mfvazquez/PulseraTermicaAVR/Informe/Informe.pdf

Laboratorio de Microcomputadoras - 66.09

# Dispositivo Autorregulador de la Percepción Térmica Corporal

Profesor: | Ing. Guillermo Campiglio
Cuatrimestre/Año: | 1º/2015
Turno de las clases prácticas | miercoles
Jefe de trabajos prácticos: | Ricardo Arias
Docente guía: | Ricardo Arias
Autores | Seguimiento del proyecto
Gaston | Martinez | 91383
Matías | Vázquez | 91523

Observaciones:
Fecha de aprobación | Firma J.T.P

Coloquio
Nota final
Firma profesor

66.09 - Laboratorio de Microcomputadoras
er Cuatrimestre de 2015

## Índice

1. Objetivos | 2
2. Diseño | 5
3. Especificaciones del microcontrolador | 9
4. Software | 10
5. Resultados | 11
6. Conclusiones | 12
A. Codigo Proyecto | 13
B. Presupuesto | 25
C. Consumo de Corriente | 25
D. Referencias | 25
E. Datasheets | 25

## 1. Objetivos

Se diseñó e implementó una pulsera térmica que regula la temperatura de la muñeca del usuario. Se utiliza un módulo termoeléctrico para enviar variaciones de calor o frío a fin de modificar la percepción térmica del cuerpo.
Su función es generar pulsos de frío o calor, de manera de generar una sensación de confort para una persona en condiciones donde la temperatura es muy alta o muy baja respectivamente. Está basado en el proyecto Wristify [1] ganador del concurso de Intel: Make It Wearable [2].

### 1.1. Diagrama de Bloques

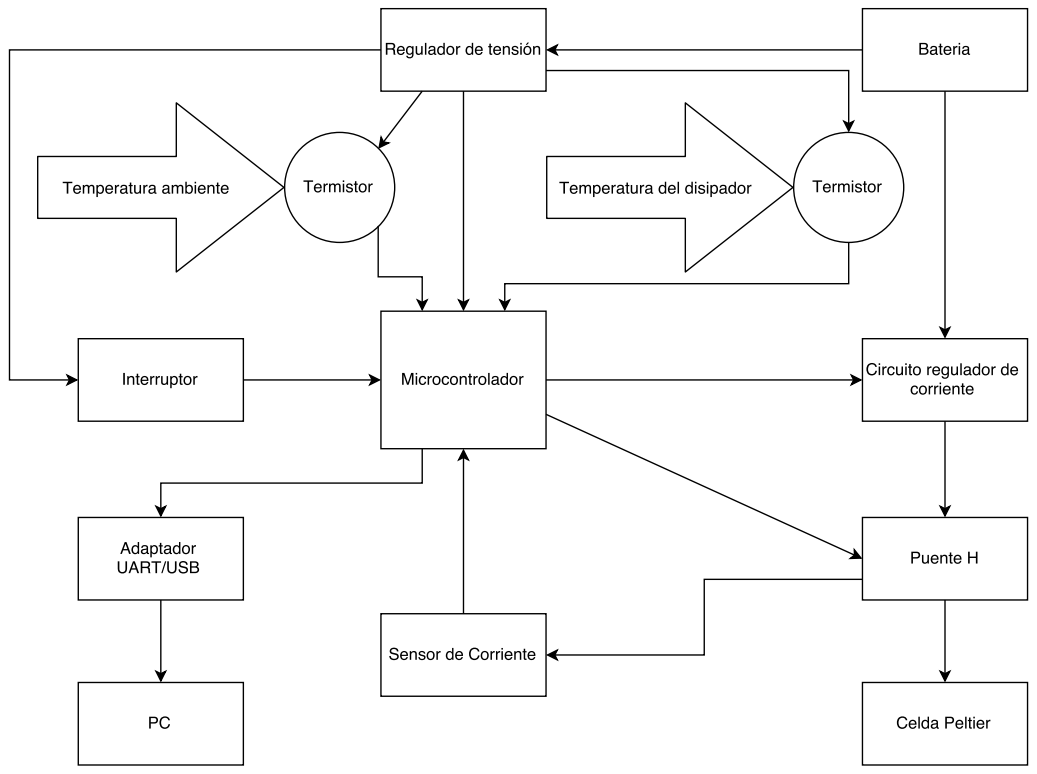
[picture p5: figure]

Figura 1: Diagrama de bloques

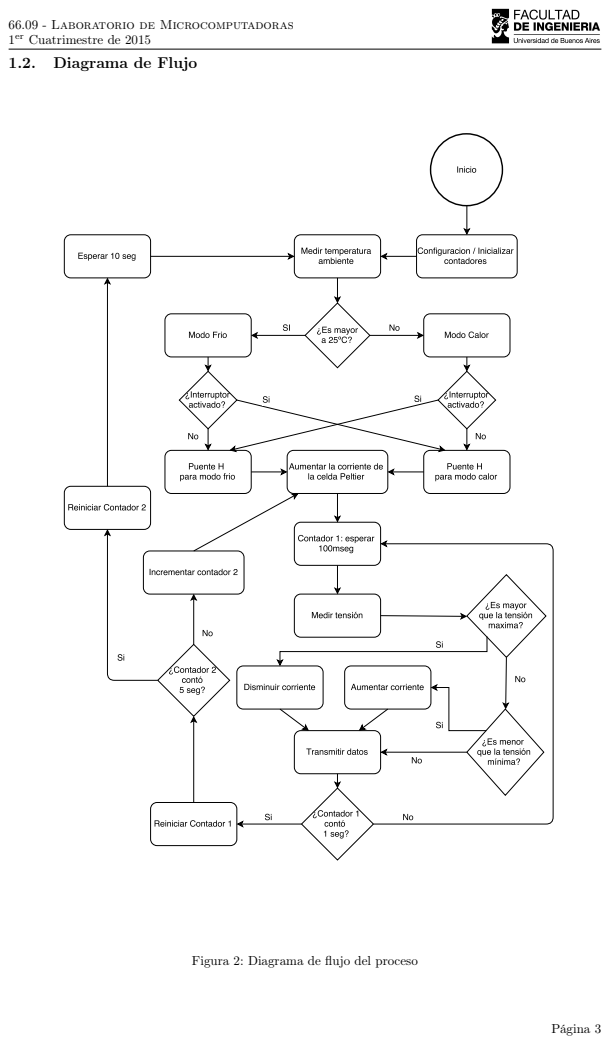
[picture p6: page 4]

1.2. Diagrama de Flujo

Figura 2: Diagrama de flujo del proceso

### 1.3. Especificaciones

El dispositivo utiliza una celda Peltier para enviar pulsos de calor o frío. De forma que se logra una diferencia de temperatura mayor a 0, 4

oC/seg. durante 5 segundos y durante los siguientes 10 segundos entra en estado de espera, para luego volver a iniciar el ciclo.
Cuenta con un termistor para medir la temperatura ambiente y analizar si debe enviar o recibir calor. Finalmente controla que se cumpla el ciclo en base a la corriente que circula por la celda Peltier.

### 1.3.1. Componentes

A continuación se lista la función de cada componente.

Celda Peltier: Realiza los cambios de temperatura en la muñeca del usuario.

Circuito regulador de corriente: Regula la corriente suministrada a la celda peltier.

Puente H: Invierte la polaridad de la celda Peltier, para así poder alternar entre modo frío o modo calor.

Disipador: La celda Peltier cuenta con un disipador para mantener la temperatura de una de sus caras a un valor cercano a la temperatura ambiente.

Termistores: Cuenta con dos termistores. Uno para medir la temperatura ambiente y en base a esta decidir el modo de trabajo, frío o calor. El segundo termistor mide la temperatura del disipador conectado a la celda Peltier para poder realizar una estimación de la temperatura de la celda.

Salida de puerto serie: Sirve para poder monitorear en una computadora la temperatura de la placa.

Adaptador UART-USB: Sirve para recibir los datos enviados desde el microcontrolador en una PC a través del puerto USB.

Bateria: Suministra la corriente necesaria a la celda Peltier y proporciona alimentación a todos los dispositivos utilizados.

Interruptor: Para poder invertir el estado de trabajo, de frío a calor y viceversa.

Controlador: Se utilizara un microcontrolador AVR. Es el encargado de obtener las temperaturas de los termistores para definir el modo de trabajo y autorregular la corriente de la celda Peltier mediante el circuito regulador de corriente.

## 2. Diseño

2.1. | Esquematico | V- 4 | V+

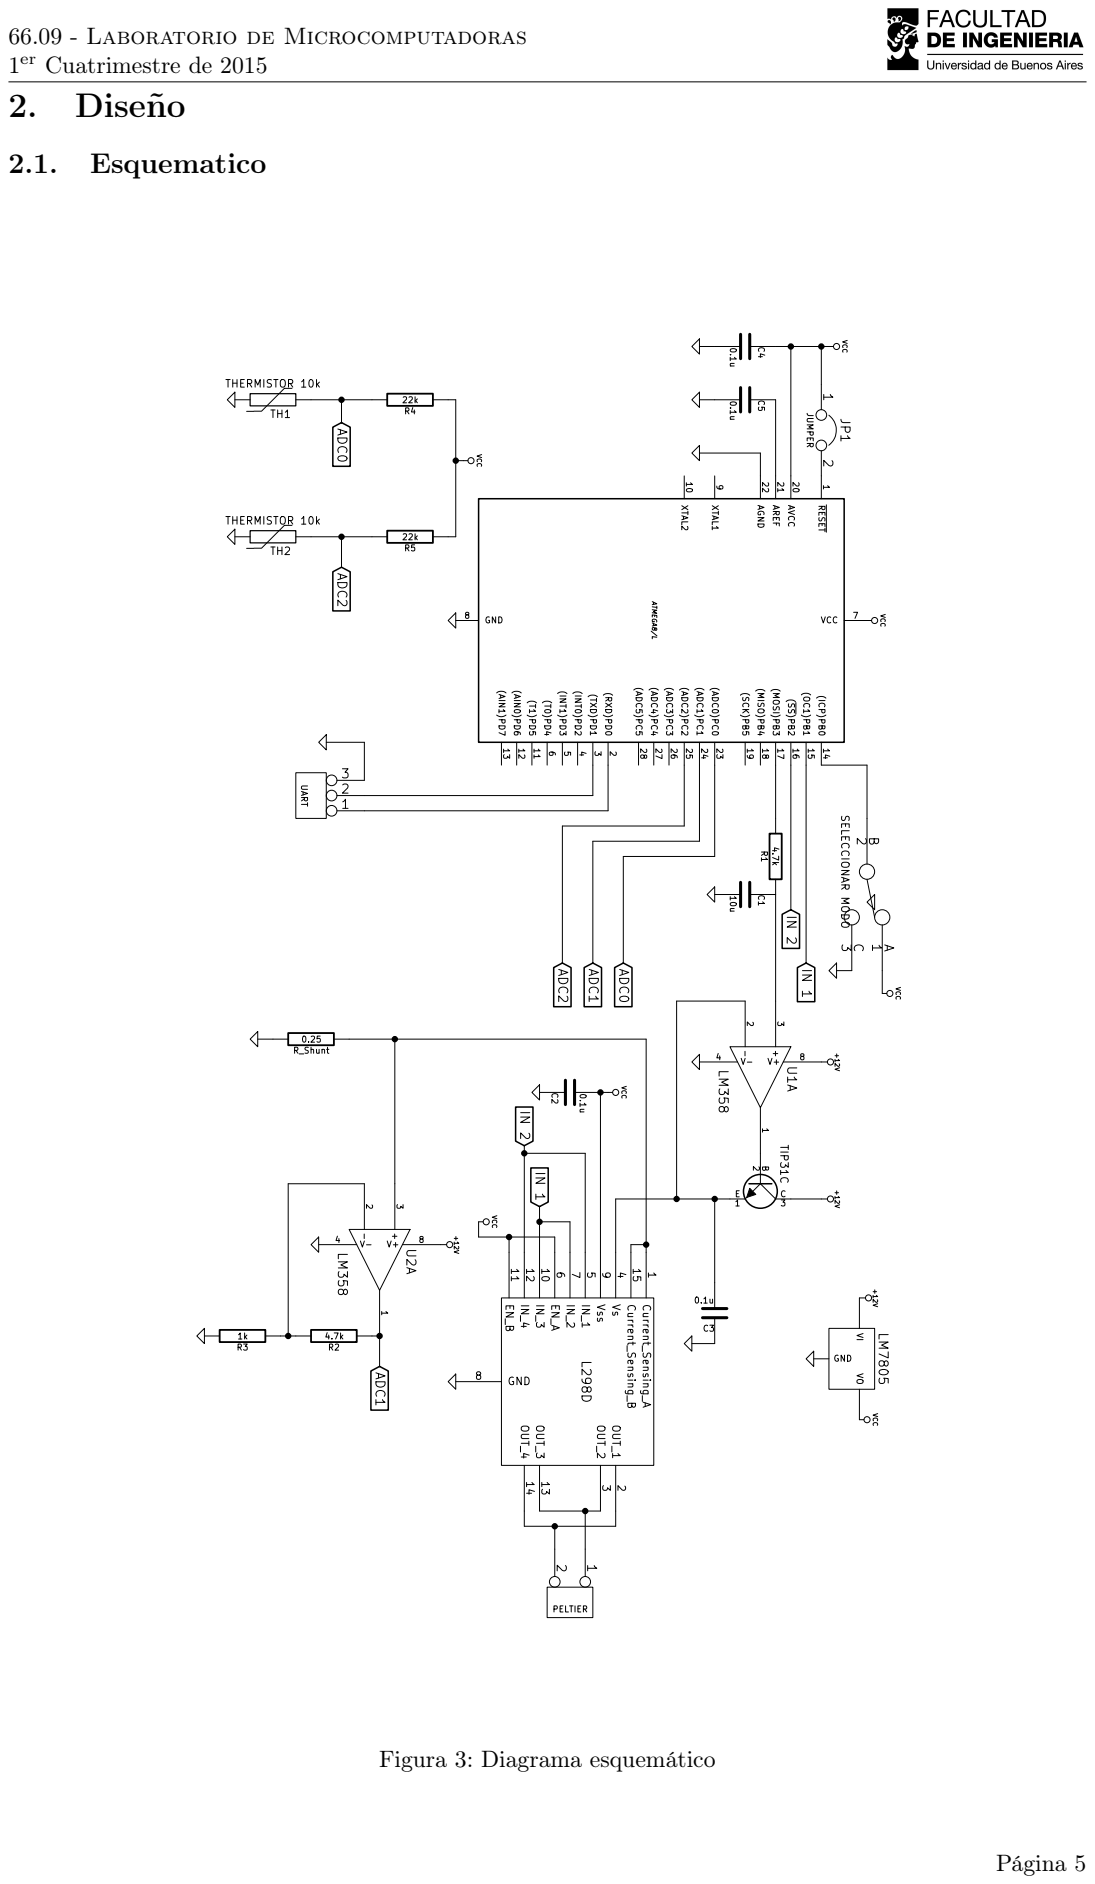
[picture p7: page 6]

### 2.2. Componentes

Celda Peltier: Celda peltier de 10W y 15 mmx15 mm

LM7805: Regulador de tensión para habilitar el puente H, alimentar el microcontrolador y suminis-trarle tensión constante a las resistencias conectadas en serie a los termistores.

Interruptor: Interruptor para activar la inversión de la polaridad.

Resistencias:

- Dos resiststencias de 4,7 kΩ
- Dos resiststencias de 22,0 kΩ
- Una resistencia de 1,0 kΩ

Capacitores:

- 1 capacitor de 10 µF para generar tensión constante del PWM recibido.
- 4 capacitores de 0.1 µF Conectados en paralelo a las alimentaciones del puente H, recomen-dados por el fabricante.

LM358: Dos amplificadores operacionales. Uno para suministrar corriente a la base del NPN y el segundo para amplificar la tensión leída sobre el shunt.

TIP31C: Transistor de potencia NPN, utilizado para regular la corriente.

L298D: Puente H utilizado para invertir la polaridad de la celda Peltier

Constantán: alambre de 2 cm (0,5 mm de diámetro) utilizado para sensar la corriente generada.

Bateria: de 12 V y 2,9 Ah

Pines:

- 3 pines para el puerto serie.
- 2 pines para el reseteo del microcontrolador.
- 2 pines para conectar la celda peltier al circuito.

Termistores: Dos termistores NTC de 10 kΩ

### 2.3. Regulador de Corriente con Puente H

Se utilizó un regulador de corriente controlado por un PWM como se muestra en la figura 4

er Cuatrimestre de 2015 | V⁻ 4 V⁺

8

1

- 2 | +
3 | U2A

LM358

E

1 B

2 TIP31C C
3 V- 4 V+

8

1

- 2 | +
3 | U1A

LM358

VI | VO GND LM7805
+12V | 1
2 | PELTIER

R1

4.7k | C1

10u

+12V | +12V
+12V | R² 4.7k 1k R³ C2
0.1u | C³ 0.1u
Current_Sensing_A 1 | OUT_1 | 2 OUT_2 | 3 Vs 4
IN_1 5 | EN_A 6
IN_2 7 | GND

8 Vss 9

IN_3 10 | EN_B 11
IN_4 12 | OUT_3 | 13 OUT_4 | 14 Current_Sensing_B 15 | L298D R_Shunt 0.25

VCC

VCC

VCC

IN 1 | ADC1

IN 2 OC2

Figura 4: Regulador de Corriente

El circuito RC filtra la señal del PWM generado por el microcontrolador. Presentando el valor medio en la entrada no inversora del LM358 U1A, cuya salida regula la corriente suministrada a la base del transistor NPN por el amplificador operacional, generando una corriente constante entre el colector y el emisor del transistor.
Se optó por utilizar un L298D para el puente H ya que cuenta en un mismo integrado con dos puentes H que soportan 2 A de corriente. Conectados en paralelo como se muestra en la figura 4 se puede duplicar dicha corriente máxima para que soporte hasta 4 A de corriente.
La corriente que circula por la celda se mide con una resistencia hecha con alambre constatán. La tensión que cae sobre este es amplificada por el LM358 U2A. Para que la tensión de salida varíe entre 0 V y 2,56 V y sea leído por el microcontrolador.
Las resistencias del amplificador U2A se obtuvieron considerando que para la corriente máxima registrada de 1,75 A, la salida no supere los 2,56 V. Siendo de 0,25 Ω la resistencia del alambre constantan .
La tensión de salida se obtiene mediante:

VADC1 = RconstantanIMAX

R3 + R2
R3

(1)

Luego fijando R3 = 1 kΩ y R2 = 4,7 kΩ se verificó que la tensión no supere los 2,56 V:

VADC1 = 0,25 Ω 1,75 A1 kΩ + 4,7 kΩ 1 kΩ = 2,49V < 2,56V

### 2.4. Medición de las temperaturas

Se utilizaron dos termistores. Uno para medir la temperatura ambiente y otro para la temperatura del disipador conectado a la celda Peltier para poder estimar la temperatura a la que se encuentra la celda. Ambos termistores están conectados de la misma manera como se indica a continuación.
Se utilizó un divisor resistivo para medir la tensión en los termistores y poder obtener la temperatura utilizando tablas con la relación entre la tensión leída y la temperatura a la que se encuentra. Se obtuvieron las resistencias a conectar en serie con los termistores de forma que la tensión máxima no supere los 2,56 V VI VO GND LM7805

+12V

# - TH2 THERMISTOR 10k 22k R5

ADC

Figura 5: Divisor de tensión de los termistores

Vtermistor = 5 V | Rtermistor
| Rtermistor + Rserie

(2)

Finalmente se eligió una resistencia de Rserie = 22 kΩ para R4 y R5 verificando que la tensión en los termistores no supere la tensión de referencia del ADC del microcontrolador para la resistencia máxima registrada en los termistores a R0

oC = 15 kΩ :

Vtermistor = 5 V | 15 kΩ
15 kΩ + 22 kΩ = 2 V

### 2.5. Interruptor selector de modo

La salida del interruptor es recibida por el microcontrolador, para en el siguiente ciclo invertir la polaridad de la celda Peltier mediante el puente H y evitar un cambio brusco de corriente en la celda Peltier.
El interruptor invierte el modo de trabajo actual. En caso de encontrarse el dispositivo a temperaturas ambiente menores a 25 oC automáticamente entra en modo calor. En caso de estar el interruptor habilitado entra en modo frío. Caso contrario ocurre para temperaturas ambiente mayores a 25 oC por defecto entra en modo frío, con el interruptor habilitado entra en modo calor.

## 3. Especificaciones del microcontrolador

### 3.1. Microcontrolador

Para este proyecto se utilizo un microcontrolador Atmega8L. El datasheet del mismo se puede obtener en la pagina de Atmel[4]

### 3.2. Configuraciones

### 3.2.1. Low Fuse

Se configuro este registro para que el clock del microcontrolador sea de 8MHz.
7 | 6 | 5 | 4 | 3 | 2 | 1 | 0
1 | 1 | 1 | 0 | 0 | 1 | 0 | 0
BODLVL | BODEN | SUT1 | SUT0 | CKSEL3 | CKSEL2 | CKSEL1 | CKSEL0

Solo se modificaron los valores de CKSEL, el resto de los bits fue dejado en la configuración que venia de fabrica.

### 3.2.2. UCSRC

Se configuro este registro para setear que el puerto serie envíe datos de 8bits, con un bit de stop y sin bit de paridad
7 | 6 | 5 | 4 | 3 | 2 | 1 | 0
1 | 0 | 0 | 0 | 0 | 1 | 1 | 0
URSEL | UMSEL | UPM1 | UPM0 | USBS | UCSZ1 | UCSZ0 | UCPOL

Configuracion segun el bit

Bit 7: Selecciona entre acceder el UCSRC seteando el bit en 1 o acceder al UBRRH seteando el bit en 0.

Bit 6: Modo Asincrónico

Bit 5 y 4: Sin bit de paridad

Bit 3: Un bit de STOP

Bit 2 y 1: Datos de 8 bits

Bit 0: 0 Por modo Asincrónico

### 3.2.3. UBRRL

Se configuro este registro para setear el Baud Rate del puerto serie a 38,4Mhz
7 | 6 | 5 | 4 | 3 | 2 | 1 | 0
0 | 0 | 0 | 0 | 1 | 1 | 0 | 0
UBRR[7:0]

### 3.2.4. TCCR2

Se configuro este registro para setear el modo de funcionamiento del contador 2.
7 | 6 | 5 | 4 | 3 | 2 | 1 | 0
0 | 1 | 1 | 1 | 0 | 0 | 0 | 1
FOC2 | WGM20 | COM21 | COM20 | WGM21 | CS22 | CS21 | CS20

Configuracion segun el bit

Bit 7: 0, por ser modo PWM

Bit 6 y 3: Modo PWM, Phase Correct

Bit 5 y 4: Modo set on match en subida y clear on match en bajada

Bit 2 - 0: Sin prescaler

### 3.2.5. ADCSRA

Se configuro este registro para el conversor analógico digital

7 | 6 | 5 | 4 | 3 | 2 | 1 | 0
1 | 1 | 0 | 0 | 1 | 1 | 1 | 1
ADEN | ADSC | ADFR | ADIF | ADIE | ADPS2 | ADPS1 | ADPS0

Configuracion segun el bit

Bit 7: Habilita ADC

Bit 6: Inicializa la conversión

Bit 5: Desabilita el free runing

Bit 4: Resetea el flag de interrupción pasandole 1

Bit 3: Habilita la interrupción

Bit 2 a 0: Factor de división: 128 para 111

## 4. Software

### 4.1. Monitoreo de datos

Durante la implementación del proyecto se monitorearon los datos manejados por el microcontrolador, para verificar su correcto funcionamiento, mediante un adaptador UART-USB. Para obtener los datos en una PC.
Finalizado el proyecto se utilizó este dispositivo para poder monitorear el correcto funcionamiento del mismo, enviando tanto la temperatura ambiente como la estimada de la celda Peltier y así poder verificar si cumple con los objetivos del proyecto.

### 4.2. Protocolo puerto serie

Para la comunicación desde el puerto serie se utilizo un protocolo con el siguiente formato:

Primer bloque: Un byte con un carácter ASCII alfanumerico identificador el dato a mandar.

Siguientes bloque: Uno o mas bytes con el dato a enviar. El receptor se debe encargar de deter-minar el largo de este en base a lo recibido en el primer bloque.

En particular para este proyecto, se utilizaron datos de un byte¹ y se enviaron con la configuración detallada en la sección 3.2.2 (Pagina: 9), con lo cual los paquetes enviados por puerto respetan el siguiente formato:

1-bit | 8-bits | 1-bit | 1-bit | 8-bits | 1-bit
START | Tipo de dato | STOP | START | Dato enviado | STOP

### 4.3. Autorregulación de la corriente

Para autorregular la corriente se armaron dos tablas, una para modo frío y otra para modo calor. En donde se muestra la relación entre la tensión amplificada del RShunt y la temperatura a la que se encuentra la celda Peltier. La tabla a utilizar depende del modo de operación, frío o calor.
Durante la ejecución del programa se recorre dicha tabla utilizando un iterador que avanza de posición en cada segundo. En base a la posición del iterador se obtienen las tensiones máximas y mínimas, para regular el PWM de forma que la tensión leída se encuentre entre dichos valores.
Las tablas se armaron de forma que en la ultima iteración no llegue a temperaturas que puedan dañar al usuario. Para el modo calor se procuró no superar los 40 oC en el fin del ciclo, y para el modo frio se procuró que la temperatura no sea menor a los 12 oC.

1Esto fue en parte una consecuencia de la elección del modelo del microcontrolador. Por otro lado, tampoco eran necesarios datos mas grandes.

## 5. Resultados

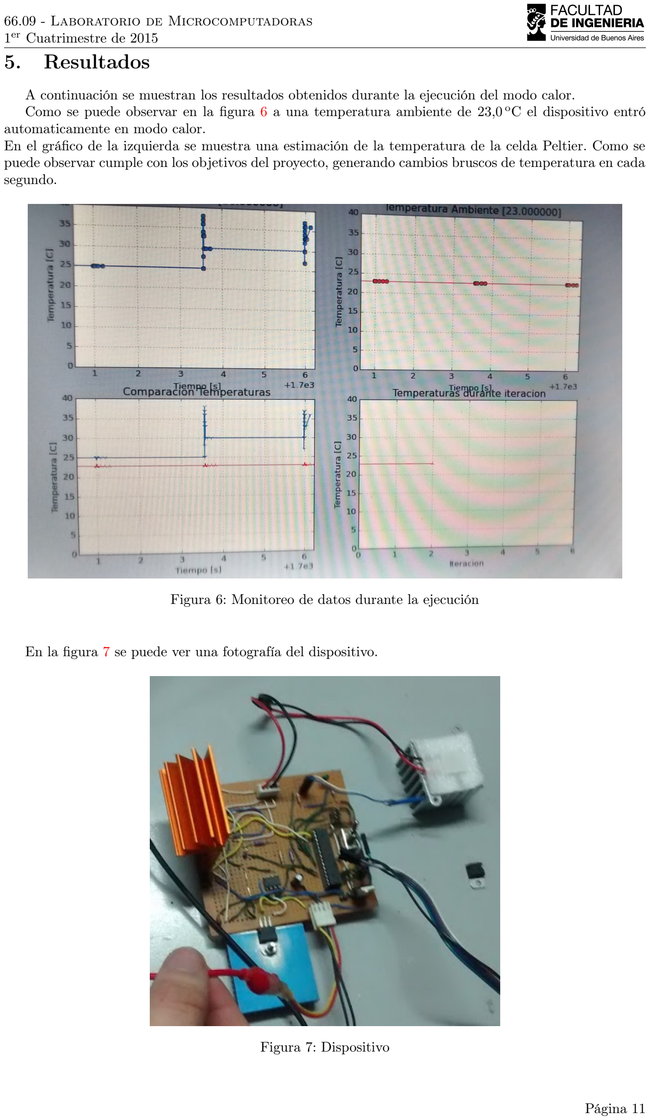
[picture p8: page 12]

A continuación se muestran los resultados obtenidos durante la ejecución del modo calor. Como se puede observar en la figura 6 a una temperatura ambiente de 23,0

oC el dispositivo entró
automaticamente en modo calor.
En el gráfico de la izquierda se muestra una estimación de la temperatura de la celda Peltier. Como se puede observar cumple con los objetivos del proyecto, generando cambios bruscos de temperatura en cada segundo.

Figura 6: Monitoreo de datos durante la ejecución

En la figura 7 se puede ver una fotografía del dispositivo.

Figura 7: Dispositivo

## 6. Conclusiones

La función del dispositivo es lograr una sensación de confort térmico mediante el envío de pulsos de calor o frío a la muñeca del usuario. Ya que el cuerpo humano al ser sometido a cambios de temperatura en alguna parte del cuerpo obtiene una sensación de frío o calor en todo el cuerpo, según el cambio sufrido.
Si bien se logró cumplir con los objetivos del proyecto, no se notaron cambios en la percepción térmica corporal, sí en la muñeca pero no en todo el cuerpo. Como se trata de algo tan relativo entre cada individuo, se deberían realizar mas pruebas con distintas diferencias de temperatura entre cada segundo, y evaluarlo a distintas temperaturas ambientes.
Las pruebas realizadas se centraron mas en el modo calor ya que actualmente nos encontramos en períodos de frío. Una tarea pendiente es probar el dispositivo durante días de calor para evaluar los efectos del modo frío.
Una posible mejora sería que el usuario pueda ajustar las diferencias de temperatura. Y que el dispositivo registre cuando el usuario utiliza el interruptor para cambiar de modo, y almacenar esa temperatura ambiente como la temperatura en la cual el dispositivo cambia de modo.
Las celdas Peltier son dispositivos muy delicados, por lo que requieren estar bien protegidas contra posibles impactos, ya que el mínimo impacto las daña permanentemente. No se logró encontrar una relación simple entre la corriente de la celda y su diferencia de temperatura, ya que esta no sólo depende de la corriente sino también de la temperatura inicial y del tiempo. Por los datos medidos para realizar las tablas se llegó a la conclusión de que la corriente fija una velocidad a la que la temperatura variará durante intervalos cortos.
Fue mas fácil regular el modo frío ya que al iniciar el standby la temperatura regresaba rápidamente a su valor inicial. En cambio para el modo calor, al iniciar el standby la celda peltier no llega a enfriarse hasta obtener su valor inicial luego del standby, por lo que en cada ciclo irá acumulando temperatura hasta llegar a un valor máximo que depende de la corriente máxima que reciba.
Una mejora a este problema sería que durante el modo calor, al iniciar el standby entre en modo frío y reduzca la temperatura del peltier hasta obtener la temperatura ambiente. El problema que conlleva esta solución es que el transistor que regula la corriente se calentará más al no tener un período de standby de 10 segundos sin transmitir corriente.
Por las mismas razones mencionadas sobre el comportamiento de la celda Peltier, deducir su temperatura en base a la temperatura del disipador y la corriente que circula por la celda devuelve datos poco precisos, lo que se podría calcular es la diferencia de temperatura entre cada pulso con el inicio del ciclo. Para medir la temperatura del Peltier se deberá poner un termistor o termocupla entre el peltier y el disipador para obtener en base a esta la temperatura del peltier.
Finalmente, para lograr las condiciones especificadas por el proyecto no es necesario generar corrientes altas. Con una corriente máxima de 500 mA bien reguladas se hubiese logrado el objetivo del producto y se habría reducido su tamaño debido a que no requiere una batería de gran tamaño.

## A. Codigo Proyecto

A.1. | Pulsera.S
1 | #include <avr / i o. h >
3 | .s e c t ion .data
.org 0 x000

5
Temp_Ambiente : | .byte 0
7 | Temp_Disipador : .byte 0
Temp_Peltier : | .byte 0
9 | Ten sion_Salida : .byte 0
11 | Modo_Operacion : .byte 0
13 | Modo_Standby : | .byte 0
15 | PWM: | .byte 0
Tension_min : | .byte 0
17 | Tension_max : | .byte 0
I t e r a d o r : | .byte 0

19
.s e c t ion .t ext
21 .org 0 x0
.g loba l main
23 | rjmp | main
25 | #define low( x ) | lo8 ( x )
#define high( x ) | hi8 ( x )

27
; Regs :
29 ; r16 : Temporal , p a s a j e de parame tro y de r e t o r n o #define Reg_Temporal r16

31
; r20 : Contador
33 | #define Contador r20
35 | ; C on s t an te s :
; T ipos de d a t o para mandar por s e r i a l

37
| #define Dato_Tempe_Ambiente | ’A’
39 | #define Dato_Tempe_Disipador | ’T ’
| #define Dato_Num_Iteracion | ’ I ’
41 | #define Dato_Tension_Salida | ’P ’
| #define Dato_Tempe_Peltier | ’X’
43 | #define Dato_PWM | ’W’
| #define Dato_max | ’M’
45 | #define Dato_min | ’N’
47 | #define Incremento_Pulso_Calor | 3
| #define Incremento_Pulso_Frio | 10
49 | #define Incremento_Regulacion | 1
| #define PWM_inicial | 95

51

53 | #define Eeprom_Inicio_Calor | 0 x64
| #define Eeprom_Inicio_Frio | 0 x94

55

57 ; S a l t e a e l v e c t o r de i n t e r r u p c i o n .org 0 x0020
59 | main:
61 | STACK_Init :
l d i | Reg_Temporal , | low(RAMEND)
63 | out | _SFR_IO_ADDR(SPL) , | Reg_Temporal
l d i | Reg_Temporal , | high(RAMEND)
65 | out | _SFR_IO_ADDR(SPH) , | Reg_Temporal
67 | r c a l l | PWM_Init
r c a l l | PUENTE_H_Init
69 | r c a l l | USART_Init
71 | LOOP:
c l r | Contador

73
r c a l l | GET_MODE | ; ob te ng o e l modo de o p e r ac i o n

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

79
REDUCIR_LOOP:

81
mov | Reg_Temporal , | Contador

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

87

89 | inc | Contador | ; Cumpli una v u e l t a
l d i | Reg_Temporal , | 6
91 | cpse | Contador , | Reg_Temporal | ;No s a l t a r s i ya e j e c u t o 5 v u e l t a s
93 | rjmp | REDUCIR_LOOP
95 | cb i | _SFR_IO_ADDR(DDRB) , 3 | ; (OC2) para s a l i d a
sb i | _SFR_IO_ADDR(DDRB) , 3 | ; (OC2) para s a l i d a
97 | cb i | _SFR_IO_ADDR(PORTB) , 3
99 | r c a l l STANDBY
rjmp LOOP

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

117 | inc | Reg_Temporal
| sts | I t e r a d o r , | Reg_Temporal
119 | r c a l l | LEER_EEPROM
| sts | Tension_min , | r25

121
| inc | Reg_Temporal
123 | inc | Reg_Temporal
| r c a l l | LEER_EEPROM
125 | sts | Tension_max , | r25
127 | lds | r29 , | PWM
out | _SFR_IO_ADDR(OCR2) , r29

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

171
| MODO_FRIO:
173 | sb i | _SFR_IO_ADDR(PORTB) , 1
cb i | _SFR_IO_ADDR(PORTB) , 2
175 | ret

177 | MODO_CALOR:
cb i | _SFR_IO_ADDR(PORTB) , 1
179 | sb i | _SFR_IO_ADDR(PORTB) , 2
| ret
181 | ;−−−−−−−−−−−−−−−−−−−−−−−−−−−−−−−−−−−−−−−−−−−−−−−−−−−−−−−−−−−−−−−−−−−−−−−−−−−−−−−−−−−−−
183 | TRANSMITIR_DATOS:
| r c a l l | LEER_AMBIENTE
185 | r c a l l | LEER_DISIPADOR
| r c a l l | LEER_PELTIER

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

193
| l d i | Reg_Temporal , | Dato_Tempe_Ambiente | ; t i p o de d a t o a mandar
195 | r c a l l | USART_Transmit
| lds | Reg_Temporal , | Temp_Ambiente
197 | r c a l l | USART_Transmit
199 | l d i | Reg_Temporal , | Dato_Tension_Salida | ; t i p o de d a t o a mandar
| r c a l l | USART_Transmit
201 | lds | Reg_Temporal , | Ten sion_Salida
| r c a l l | USART_Transmit

203
| l d i | Reg_Temporal , | Dato_Tempe_Disipador | ; t i p o de d a t o a mandar
205 | r c a l l | USART_Transmit
| lds | Reg_Temporal , | Temp_Disipador
207 | r c a l l | USART_Transmit
209 | l d i | Reg_Temporal , | Dato_Tempe_Peltier | ; t i p o de d a t o a mandar
| r c a l l | USART_Transmit
211 | lds | Reg_Temporal , | Temp_Peltier
| r c a l l | USART_Transmit

213
| l d i | Reg_Temporal , | Dato_PWM | ; t i p o de d a t o a mandar
215 | r c a l l | USART_Transmit
| lds | Reg_Temporal , | PWM
217 | r c a l l | USART_Transmit
219 | l d i | Reg_Temporal , | Dato_min | ; t i p o de d a t o a mandar
| r c a l l | USART_Transmit
221 | lds | Reg_Temporal , | Tension_min
| r c a l l | USART_Transmit

223
| l d i | Reg_Temporal , | Dato_max | ; t i p o de d a t o a mandar
225 | r c a l l | USART_Transmit
| lds | Reg_Temporal , | Tension_max
227 | r c a l l | USART_Transmit
229 | ret
231 | ;−−−−−−−−−−−−−−−−−−−−−−−−−−−−−−−−−−−−−−−−−−−−−−−−−−−−−−−−−−−−−−−−−−−−−−−−−−−−−−−−−−−−−
LEER_AMBIENTE:
233 | l d i | Reg_Temporal , | 0 b11000000 | ; c a n al 0 tem pe r a tu r a amb ien te
| r c a l l | READ_ADC | | ; l e e r t e n s i o n d e l p e l t i e r
235 | r c a l l | TRADUCIR_TERMISTOR
| sts | Temp_Ambiente , | Reg_Temporal

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

257
| SET_PWM:
259 | lds | r30 , PWM
| lds | Reg_Temporal , | Modo_Standby
261 | cp i | Reg_Temporal , | 1
; S i e s t a en modo s t a n d by no r e a l i z a camb ios
263 | breq | APLICAR_CAMBIO
265 | lds | r29 , | Ten sion_Salida
| lds | r17 , | Tension_min
267 | lds | r18 , | Tension_max
l d i | r26 , | Incremento_Regulacion ; v a l o r a s e r r e s t a d o o | sumado

269
| cp | r29 , | r17
271 | brlo | AUMENTAR
273 | cp | r29 , | r18
| brlo | APLICAR_CAMBIO

275
| DISMINUIR :
277 | cp i | r30 , | 100
| breq | APLICAR_CAMBIO
279 | add | r30 , | r26
| rjmp | APLICAR_CAMBIO
281 | AUMENTAR:
| cp i | r30 , | 0
283 | breq | APLICAR_CAMBIO
| sub | r30 , | r26
285 | APLICAR_CAMBIO:
| sts | PWM, | r30
287 | out | _SFR_IO_ADDR(OCR2) , r30
| ret
289 | ;−−−−−−−−−−−−−−−−−−−−−−−−−−−−−−−−−−−−−−−−−−−−−−−−−−−−−−−−−−−−−−−−−−−−−−−−−−−−−−−−−−−−−
; Aumenta e l p u l s o de c a l o r / f r i o d e l segundo que r e c i e n emp ieza ,
291 ; Carga l a t e n s i o n minima y maxima l e i d a s de eeprom de l a i t e r a c i o n
; c o r r e s p o n d i e n t e .
293 | AUMENTAR_PULSO:
| c l r | r17

295
| lds | Reg_Temporal , | I t e r a d o r

297 | inc | Reg_Temporal
| inc | Reg_Temporal
299 | sts | I t e r a d o r , | Reg_Temporal
301 | r c a l l | LEER_EEPROM
| sts | Tension_min , | r25
303 | inc | Reg_Temporal
| inc | Reg_Temporal
305 | r c a l l | LEER_EEPROM
| sts | Tension_max , | r25

307
| lds | r31 , | Modo_Operacion
309 | cp i | r31 , | 0
| breq | AUMENTO_FRIO
311 | AUMENTO_CALOR:
l d i | r26 , | Incremento_Pulso_Calor
313 | r c a l l AUMENTAR
| ret
315 | AUMENTO_FRIO:
l d i | r26 , | Incremento_Pulso_Frio
317 | r c a l l | AUMENTAR
| ret

319
;−−−−−−−−−−−−−−−−−−−−−−−−−−−−−−−−−−−−−−−−−−−−−−−−−−−−−−−−−−−−−−−−−−−−−−−−−−−−−−−−−−−−−
321 | ; Espera d u r an te 100mseg
| DEMORA:
323 | l d i | Reg_Temporal , | 0xCF | ; V al o re s de l o s que emp ieza | a c o n t a r
out | _SFR_IO_ADDR(TCNT1H) , Reg_Temporal
325 | l d i | Reg_Temporal , | 0x2B
out | _SFR_IO_ADDR(TCNT1L) , Reg_Temporal
327 | l d i | Reg_Temporal , | 4 | ; 0000 0100 h a b i l i t a poner en 1
out | _SFR_IO_ADDR(TIFR ) , Reg_Temporal | ; R e i n i c i a e l o v e r f l o w f l a g
329 | out | _SFR_IO_ADDR(TIMSK) , Reg_Temporal | ; b i t 2 en 1 h a b i l i t a l a i n t e r r u p c i o n por o v e r f l o w
| l d i | Reg_Temporal , | 0 b00000011 | ; v e l o c i d a d : c l k /64
331 | out | _SFR_IO_ADDR(TCCR1B) , Reg_Temporal
333 | DEMORA_LOOP:
in | Reg_Temporal , | _SFR_IO_ADDR(TIFR)
335 | sbrs | Reg_Temporal , | 2
| rjmp | DEMORA_LOOP

337
| l d i | Reg_Temporal , | 1
339 | out | _SFR_IO_ADDR(TIFR ) , Reg_Temporal | ; Se l im p i a TIRF
| c l r | Reg_Temporal | | ; f i n a l i z o c on t a d o r
341 | out | _SFR_IO_ADDR(TIFR ) , Reg_Temporal
out | _SFR_IO_ADDR(TCCR1B) , Reg_Temporal

343
ret

345

347 ;−−−−−−−−−−−−−−−−−−−−−−−−−−−−−−−−−−−−−−−−−−−−−−−−−−−−−−−−−−−−−−−−−−−−−−−−−−−−−−−−−−−−− ; S tandby
349 ; Espera d u r an te 10 segundos , s e t e a e l PWM en 255 para no ge ne r a r c o r r i e n t e .
STANDBY:
351 | l d i | Reg_Temporal , | 1
| sts | Modo_Standby , | Reg_Temporal
353 | l d i | r29 , | 255 | ;PWM
| sts | PWM, | r29
355 | r c a l l | SET_PWM
| l d i | r27 , | 100

357 | r c a l l | ESPERA
| c l r | Reg_Temporal
359 | sts | Modo_Standby , | Reg_Temporal
| ret

361
;−−−−−−−−−−−−−−−−−−−−−−−−−−−−−−−−−−−−−−−−−−−−−−−−−−−−−−−−−−−−−−−−−−−−−−−−−−−−−−−−−−−−− 363 ; Transm it
; Transm i te por e l p u e r t o p a r a l e l o e l d a t o pasado como parame tro
365 | ; Reg_Temporal : v a l o r a t r a n s m i t i r
367 | USART_Transmit :
sb is | _SFR_IO_ADDR(UCSRA) ,UDRE | ; Espero a que se l i b e r e e l UDRE
369 | rjmp | USART_Transmit
371 | out | _SFR_IO_ADDR(UDR) , | Reg_Temporal
| ret

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

377
| USART_Init :
379 | l d i | Reg_Temporal , | (1<<TXEN) | ; e n a bl e
out | _SFR_IO_ADDR(UCSRB) , Reg_Temporal

381
l d i | Reg_Temporal , | (1<<URSEL)|(3<<UCSZ0) | ; 8 b i t s , 1 b i t de s t o p | , s i n b i t de p a r i d a d
383 | out | _SFR_IO_ADDR(UCSRC) , Reg_Temporal
385 | l d i | Reg_Temporal , | 0xC | ; Baud 38400 ( Clock de 8Mhz)
out | _SFR_IO_ADDR(UBRRL) , Reg_Temporal

387
ret

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

395
| READ_ADC:

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

401
WAIT_ADC:
403 | ; Espera a que f i n a l i c e l a l e c t u r a
| in | Reg_Temporal , | _SFR_IO_ADDR(ADCSRA)
405 | sbrs | Reg_Temporal , | 4
| rjmp | WAIT_ADC

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

409
| in | Reg_Temporal , | _SFR_IO_ADDR(ADCL)
411 | in | r17 , | _SFR_IO_ADDR(ADCH)
| l s r | r17
413 | ror | Reg_Temporal
| l s r | r17
415 | ror | Reg_Temporal

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

427
;−−−−−−−−−−−−−−−−−−−−−−−−−−−−−−−−−−−−−−−−−−−−−−−−−−−−−−−−−−−−−−−−−−−−−−−−−−−−−−−−−−−−− 429 ; Traduc ir t e r m i s t o r
; C o n v i e r t e e l v a l o r r e c i b i d o por parame tro en su tem pe r a tu r a e q u i v a l e n t e
431 | ; en t r a d a : Reg_Temporal : v a l o r l e i d o por e l ADC
433 | TRADUCIR_TERMISTOR:
| mov | r18 , | Reg_Temporal
435 | l d i | r17 , | 0 | ; t a b l a t e r m i s t o r
| l d i | Reg_Temporal , | 0 | ; i n d i c e
437 | LOOP_BUSQUEDA_TERM:
| r c a l l | LEER_EEPROM
439 | cp i | r25 , | 0
| breq | FIN_TABLA
441 | cp | r18 , | r25 | ; l e i d o v s v a l o r t a b l a
| brsh | END_TERMISTOR
443 | inc | Reg_Temporal
| inc | Reg_Temporal
445 | rjmp | LOOP_BUSQUEDA_TERM
447 | END_TERMISTOR:
| inc | Reg_Temporal
449 | r c a l l | LEER_EEPROM
| mov | Reg_Temporal , | r25
451 | ret
453 | FIN_TABLA:
| dec | Reg_Temporal
455 | dec | Reg_Temporal
| rjmp | END_TERMISTOR

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

463
TRADUCIR_PELTIER:
465 | lds | r18 , | Ten sion_Salida
| l d i | r17 , | 0 | ; t a b l a t e r m i s t o r
467 | lds | r31 , | Modo_Operacion
| cp i | r31 , | 0
469 | breq | TABLA_FRIO_PELTIER
TABLA_CALOR_PELTIER:
471 | l d i | Reg_Temporal , | Eeprom_Inicio_Calor
rjmp | LOOP_BUSQUEDA_TERM_PELTIER
473 | TABLA_FRIO_PELTIER:
l d i | Reg_Temporal , | Eeprom_Inicio_Frio
475 | rjmp | LOOP_BUSQUEDA_TERM_PELTIER

477 | LOOP_BUSQUEDA_TERM_PELTIER:
r c a l l | LEER_EEPROM
479 | cp i | r25 , | 0xFF
breq | FIN_TABLA_PELTIER
481 | cp | r25 , | r18 | ; v a l o r t a b l a v s l e i d o
brsh | END_PELTIER
483 | inc | Reg_Temporal
inc | Reg_Temporal
485 | rjmp | LOOP_BUSQUEDA_TERM_PELTIER
END_PELTIER:
487 | inc | Reg_Temporal
r c a l l | LEER_EEPROM
489 | lds | r17 , | Temp_Disipador
lds | r18 , | Modo_Operacion

491
mov | Reg_Temporal , | r25

493
sbrc | r18 , | 0
495 | rjmp | CALCULO_CALOR
rjmp | CALCULO_FRIO

497
CALCULO_CALOR:
499 | add | Reg_Temporal , | r17
sts | Temp_Peltier , | Reg_Temporal
501 | ret
503 | CALCULO_FRIO:
sub | r17 , | Reg_Temporal
505 | mov | Reg_Temporal , | r17
sts | Temp_Peltier , | Reg_Temporal
507 | ret
509 | FIN_TABLA_PELTIER:
dec | Reg_Temporal
511 | dec | Reg_Temporal
rjmp | END_PELTIER

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

525
HOT_MODE:
527 | sb ic | _SFR_IO_ADDR(PINB) , 0 | ; S i e l p in e s t a en 1 cambia | de modo
rjmp | SET_COLD

529
SET_HOT:
531 | cb i _SFR_IO_ADDR(PORTB) , | 1
sb i _SFR_IO_ADDR(PORTB) , | 2

533
| l d i | Reg_Temporal , | 1 | ; 1 e s modo c a l o r
535 | sts | Modo_Operacion , | Reg_Temporal | ; Modo_Operacion modo de o p e r ac i o n i n i c i a l

537 | ret
539 | COLD_MODE:
sb ic | _SFR_IO_ADDR(PINB) , 0 | ; S i e l p in e s t a en 1 cambia | de modo
541 | rjmp | SET_HOT
543 | SET_COLD:
sb i _SFR_IO_ADDR(PORTB) , | 1
545 | cb i _SFR_IO_ADDR(PORTB) , | 2
547 | l d i | Reg_Temporal , | 0 | ; 0 e s e l modo f r i o
| sts | Modo_Operacion , | Reg_Temporal | ; Modo_Operacion modo de o p e r ac i o n i n i c i a l

549
| ret

551
.s e c t ion .eeprom
553 | .org | 0 x0000
555 | ; T abl a s de c o n v e r s i o n
; Formato : [ ( Tens ion medida , Temperatura ∗2 ) , . . . ]
557 | .byte | 204 , | 30
.byte | 204 , | 31
559 | .byte | 204 , | 32
.byte | 204 , | 33
561 | .byte | 204 , | 34
.byte | 204 , | 35
563 | .byte | 204 , | 36
.byte | 204 , | 37
565 | .byte | 204 , | 38
.byte | 201 , | 39
567 | .byte | 199 , | 40
.byte | 197 , | 41
569 | .byte | 195 , | 42
.byte | 194 , | 43
571 | .byte | 193 , | 44
.byte | 192 , | 45
573 | .byte | 190 , | 46
.byte | 188 , | 47
575 | .byte | 186 , | 48
.byte | 184 , | 49
577 | .byte | 182 , | 50
.byte | 181 , | 51
579 | .byte | 172 , | 52
.byte | 169 , | 53
581 | .byte | 166 , | 54
.byte | 163 , | 55
583 | .byte | 160 , | 56
.byte | 159 , | 57
585 | .byte | 158 , | 58
.byte | 157 , | 59
587 | .byte | 156 , | 60
.byte | 155 , | 62
589 | .byte | 154 , | 64
.byte | 153 , | 66
591 | .byte | 152 , | 68
.byte | 151 , | 70
593 | .byte | 147 , | 72
.byte | 145 , | 74
595 | .byte | 143 , | 76
.byte | 141 , | 78

597 | .byte | 140 , | 80
.byte | 0 , 0 ;FIN DE TABLA

599
; TABLA PARA MODO CALOR
601 | ; Formato : [ Tens ion minima , Dif_Temperatura ∗2 ]
.org | 0 x0064
603 | .byte | 0 | , | 0
| .byte | 1 | , | 0
605 | .byte | 20 | , | 10
| .byte | 25 | , | 15
607 | .byte | 30 | , | 17
| .byte | 35 | , | 21
609 | .byte | 40 | , | 23
| .byte | 50 | , | 24
611 | .byte | 55 | , | 18
| .byte | 58 | , | 20
613 | .byte | 60 | , | 24
| .byte | 62 | , | 28
615 | .byte | 70 | , | 7
.byte | 0xFF , 0xFF ;FIN DE TABLA

617
; TABLA PARA MODO FRIO
619 | ; Formato : [ Tens ion minima , Dif_Temperatura ∗2 ]
621 | .org | 0 x0094
| .byte | 0 | , | 0
623 | .byte | 1 | , | 0
| .byte | 30 | , | 14
625 | .byte | 35 | , | 16
| .byte | 40 | , | 18
627 | .byte | 45 | , | 20
| .byte | 50 | , | 22
629 | .byte | 60 | , | 30
.byte | 100 , | 36
631 | .byte | 110 , | 40
.byte | 115 , | 42
633 | .byte | 0xFF , 0xFF ;FIN DE TABLA
635 | .end

A.2. | Makefile
1 | EXE = p ul s e r a
MICRO = atmega8

3
MSG_EEPROM = Creando a r c hi v o para l a EEPROM: 5 FORMAT = i h e x

7
a l l : $ (EXE ) . hex $ (EXE ) . eep

9
cl e a n :
11 | rm −f ∗ . hex ∗ . o ∗ . e l f ∗ . eep ∗ . d ∗ . syb
13 | $ (EXE ) . e l f : $ (EXE ) . S
#avr−gcc −Wall −g −g2 −g s t a b s −O0 −f p ack−s t r u c t −f s h o r t −enums −f u n s i g n e d−char −f u n s i g n e d−b i t f i e l d s −mmcu=$ (MICRO) −MMD −MP −c −o $ (EXE) . e l f $ (EXE) . S −Wa,−as=$ (EXE) . syb

15 | avr−gcc −Wall −Wextra −p e da n ti c −g −mmcu=$ (MICRO) $ (EXE ) . S −o $ (EXE ) . e l f
−Wa,−a s=$ (EXE ) . syb #−O3
17 | send : | $ (EXE ) . hex $ (EXE ) . eep
sudo avrdude −c u s b ti n y −p m8 −U f l a s h :w: $ (EXE ) . hex : i

19
send_ table : $ (EXE ) . hex $ (EXE ) . eep
21 | sudo avrdude −c u s b ti n y −p m8 −U f l a s h :w: $ (EXE ) . hex : i −U eeprom :w: $ (EXE ) . eep : i
23 | $ (EXE ) . hex : $ (EXE ) . e l f
| avr−ob jcopy −O i h e x $ (EXE ) . e l f $ (EXE ) . hex

25
#$ (EXE) . eep : $ (EXE) . e l f

27 | # | avr−o b j c o py −j . eeprom −−no−change−warn ings −−change−s e c t i o n −lma . eeprom=0 −O i h e x $ (EXE) . e l f $ (EXE) . eep
29 | show_size : $ (EXE ) . e l f
| | avr−s i z e −−forma t=avr −−mcu=atmega8 $ (EXE ) . e l f

31

33 | $ (EXE ) . eep : $ (EXE ) . e l f
| @echo
35 | @echo $ (MSG_EEPROM) $@
| −avr−ob jcopy −j . eeprom −−s e t−s e c ti o n −f l a g s =.eeprom=" a l l o c , loa d " \
37 | −−change−s e c ti o n −lma . eeprom=0 −O $ (FORMAT) $< $@

## B. Presupuesto

Componente | Precio xU | Cantidad | Precio total
Celda Peltier 10W 15 mmx15 mm | $120.00 | 1 | $120.00
Atmega8-L | $42.00 | 1 | $42.00
L298 | $47.00 | 1 | $47.00
LM358 | $8.00 | 1 | $8.00
LM7850 | $5.00 | 1 | $5.00
Disipador | $12.00 | 3 | $36.00
Termistor | $7.00 | 2 | $14.00
Resistencia | $0.50 | 5 | $2.50
Capacitor | $0.50 | 5 | $2.50
Bateria | $160.00 | 1 | $160.00
Interruptor | $5.00 | 1 | $5.00
Placa perforada | $26.00 | 1 | $26.00
Adaptador UART/USB | $152.00 | 1 | $152.00
Total | | | $620.00

## C. Consumo de Corriente

Se obtuvieron distintas corrientes máximas para cada modo:

Modo frio: 1,00 A

Modo calor: 400 mA

## D. Referencias

[1] http://www.embrlabs.com/
[2] https://youtu.be/sDZHITVfYrI
[3] https://youtu.be/kvUMCip-r4A
[4] http://www.atmel.com/images/atmel-2486-8-bit-avr-microcontroller-atmega8_

l_datasheet.pdf (http://www.atmel.com/images/atmel-2486-8-bit-avr-microcontroller-atmega8_l_datasheet.pdf)

## E. Datasheets

## Features

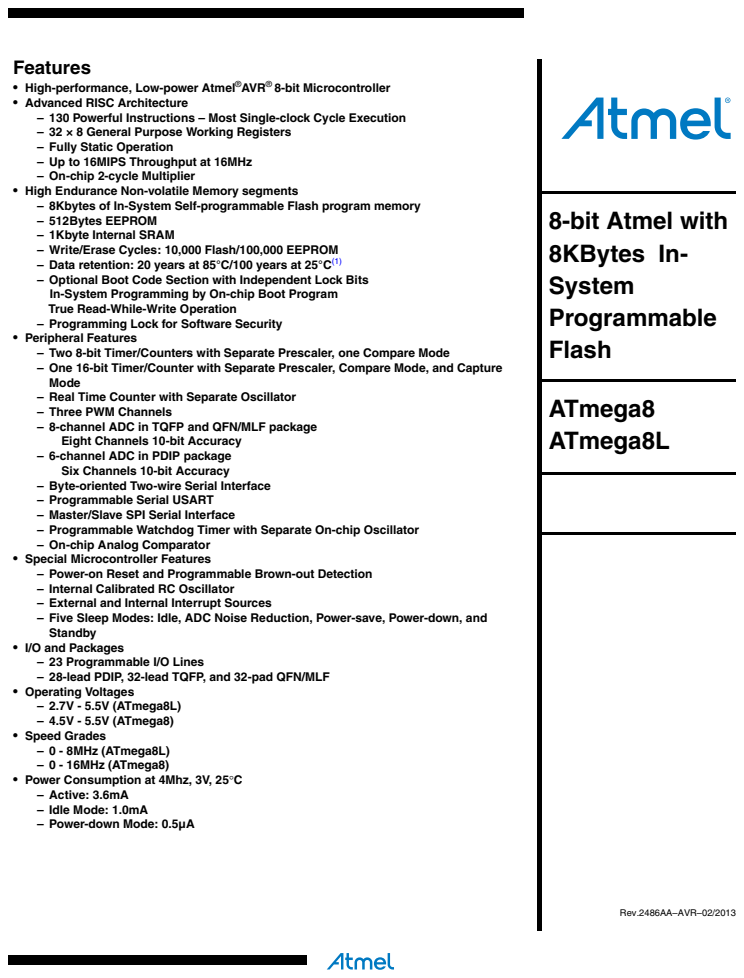
[picture p9: page 27]
8-bit Atmel with 8KBytes In- System Programmable Flash; ATmega8 ATmega8L; Rev.2486AA–AVR–02/2013

• High-performance, Low-power Atmel®AVR® 8-bit Microcontroller
• Advanced RISC Architecture
– 130 Powerful Instructions – Most Single-clock Cycle Execution
– 32 × 8 General Purpose Working Registers
– Fully Static Operation
– Up to 16MIPS Throughput at 16MHz
– On-chip 2-cycle Multiplier
• High Endurance Non-volatile Memory segments
– 8Kbytes of In-System Self-programmable Flash program memory
– 512Bytes EEPROM
– 1Kbyte Internal SRAM
– Write/Erase Cycles: 10,000 Flash/100,000 EEPROM
– Data retention: 20 years at 85°C/100 years at 25°C⁽¹⁾
– Optional Boot Code Section with Independent Lock Bits
In-System Programming by On-chip Boot Program
True Read-While-Write Operation
– Programming Lock for Software Security
• Peripheral Features
– Two 8-bit Timer/Counters with Separate Prescaler, one Compare Mode
– One 16-bit Timer/Counter with Separate Prescaler, Compare Mode, and Capture
Mode
– Real Time Counter with Separate Oscillator
– Three PWM Channels
– 8-channel ADC in TQFP and QFN/MLF package
Eight Channels 10-bit Accuracy
– 6-channel ADC in PDIP package
Six Channels 10-bit Accuracy
– Byte-oriented Two-wire Serial Interface
– Programmable Serial USART
– Master/Slave SPI Serial Interface
– Programmable Watchdog Timer with Separate On-chip Oscillator
– On-chip Analog Comparator
• Special Microcontroller Features
– Power-on Reset and Programmable Brown-out Detection
– Internal Calibrated RC Oscillator
– External and Internal Interrupt Sources
– Five Sleep Modes: Idle, ADC Noise Reduction, Power-save, Power-down, and
Standby

• I/O and Packages
– 23 Programmable I/O Lines
– 28-lead PDIP, 32-lead TQFP, and 32-pad QFN/MLF
• Operating Voltages
– 2.7V - 5.5V (ATmega8L)
– 4.5V - 5.5V (ATmega8)
• Speed Grades
– 0 - 8MHz (ATmega8L)
– 0 - 16MHz (ATmega8)
• Power Consumption at 4Mhz, 3V, 25°C
– Active: 3.6mA
– Idle Mode: 1.0mA
– Power-down Mode: 0.5µA

2

2486AA–AVR–02/2013

# ATmega8(L)

## Pin Configurations

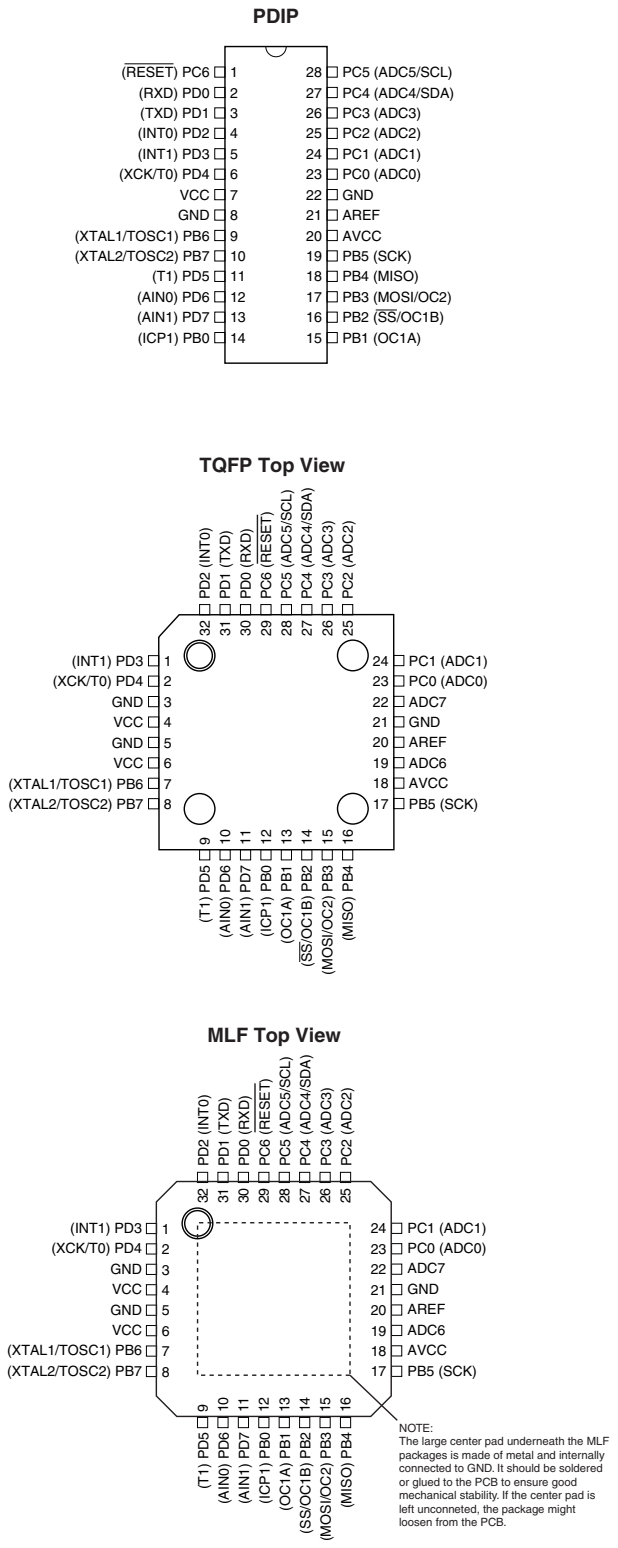
[picture p10: figure]
(INT1) PD3; (XCK/T0) PD4; GND VCC; (XTAL1/TOSC1) PB6; (XTAL2/TOSC2) PB7; PC1 (ADC1); PC0 (ADC0); ADC7; GND; AREF; ADC6; AVCC; PB5 (SCK); (AIN0) PD6; (AIN1) PD7; (ICP1) PB0; (MOSI/OC2) PB3; (MISO) PB4; PD2 (INT0); PD1 (TXD); PD0 (RXD); PC6 (RESET); PC5 (ADC5/SCL); PC4 (ADC4/SDA); PC3 (ADC3); PC2 (ADC2); TQFP Top View; (RESET) PC6; (RXD) PD0; (TXD) PD1; (INT0) PD2; (XCK/T0) PD4 VCC; PB4 (MISO) PB3 (MOSI/OC2) PB2 (SS/OC1B); PDIP; MLF Top View; NOTE: The large center pad underneath the MLF; connected to GND. It should be soldered or glued to the PCB to ensure good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

packages is made of metal and internally

mechanical stability. If the center pad is

# NTC Thermistor：TTC05 Series

# Ф5 mm Lead Type for Temperature Sensing/Compensation

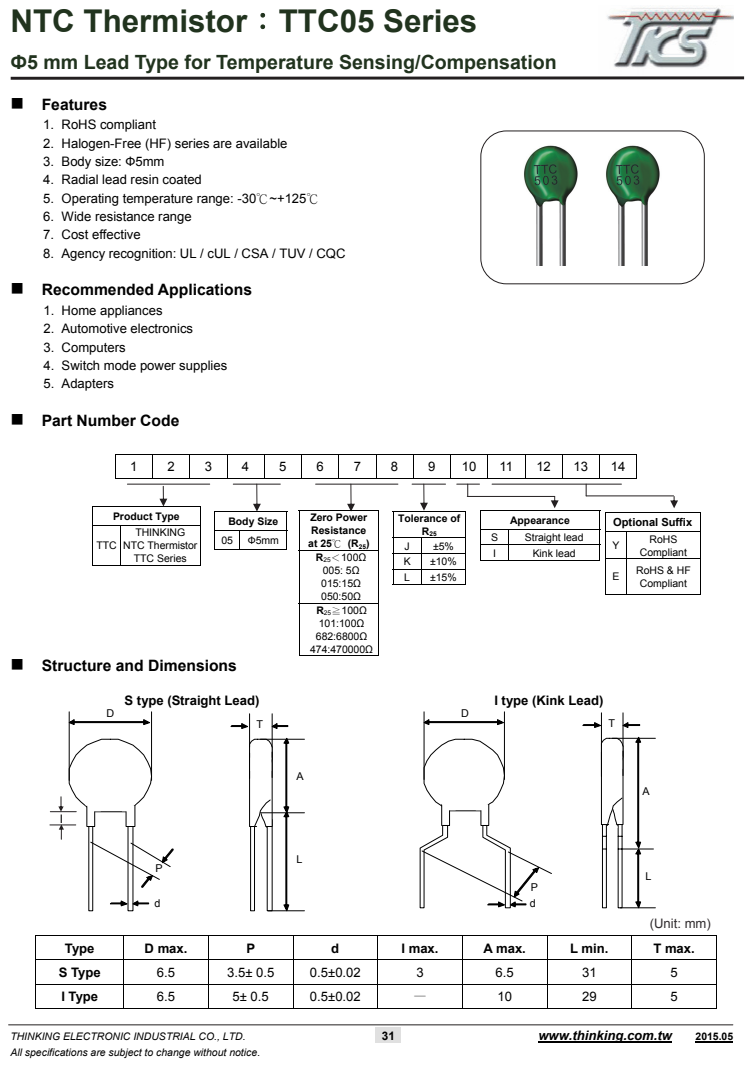
[picture p11: page 29]
THINKING ELECTRONIC INDUSTRIAL CO., LTD.; www.thinking.com.tw; Product Type; Body Size; Zero Power Resistance at 25℃ (R25) R25＜100Ω 005: 5Ω 015:15Ω 050:50Ω R25≧100Ω 101:100Ω 682:6800Ω 474:470000Ω; Tolerance of; Appearance; Straight lead; Optional Suffix; RoHS; Compliant; S type (Straight Lead); I type (Kink Lead); (Unit: mm)

■ Features
1. RoHS compliant
2. Halogen-Free (HF) series are available
3. Body size: Ф5mm
4. Radial lead resin coated
5. Operating temperature range: -30℃~+125℃
6. Wide resistance range
7. Cost effective
8. Agency recognition: UL / cUL / CSA / TUV / CQC
■ Recommended Applications
1. Home appliances
2. Automotive electronics
3. Computers
4. Switch mode power supplies
5. Adapters
■ Part Number Code

TTC | THINKING NTC Thermistor TTC Series

I | Kink lead

E | RoHS & HF Compliant

■ Structure and Dimensions

Type | D max. | P | d | I max. | A max. | L min. | T max.
S Type | 6.5 | 3.5± 0.5 | 0.5±0.02 | 3 | 6.5 | 31 | 5
I Type | 6.5 | 5± 0.5 | 0.5±0.02 | — | 10 | 29 | 5

All specifications are subject to change without notice.

L298

# DUAL FULL-BRIDGE DRIVER

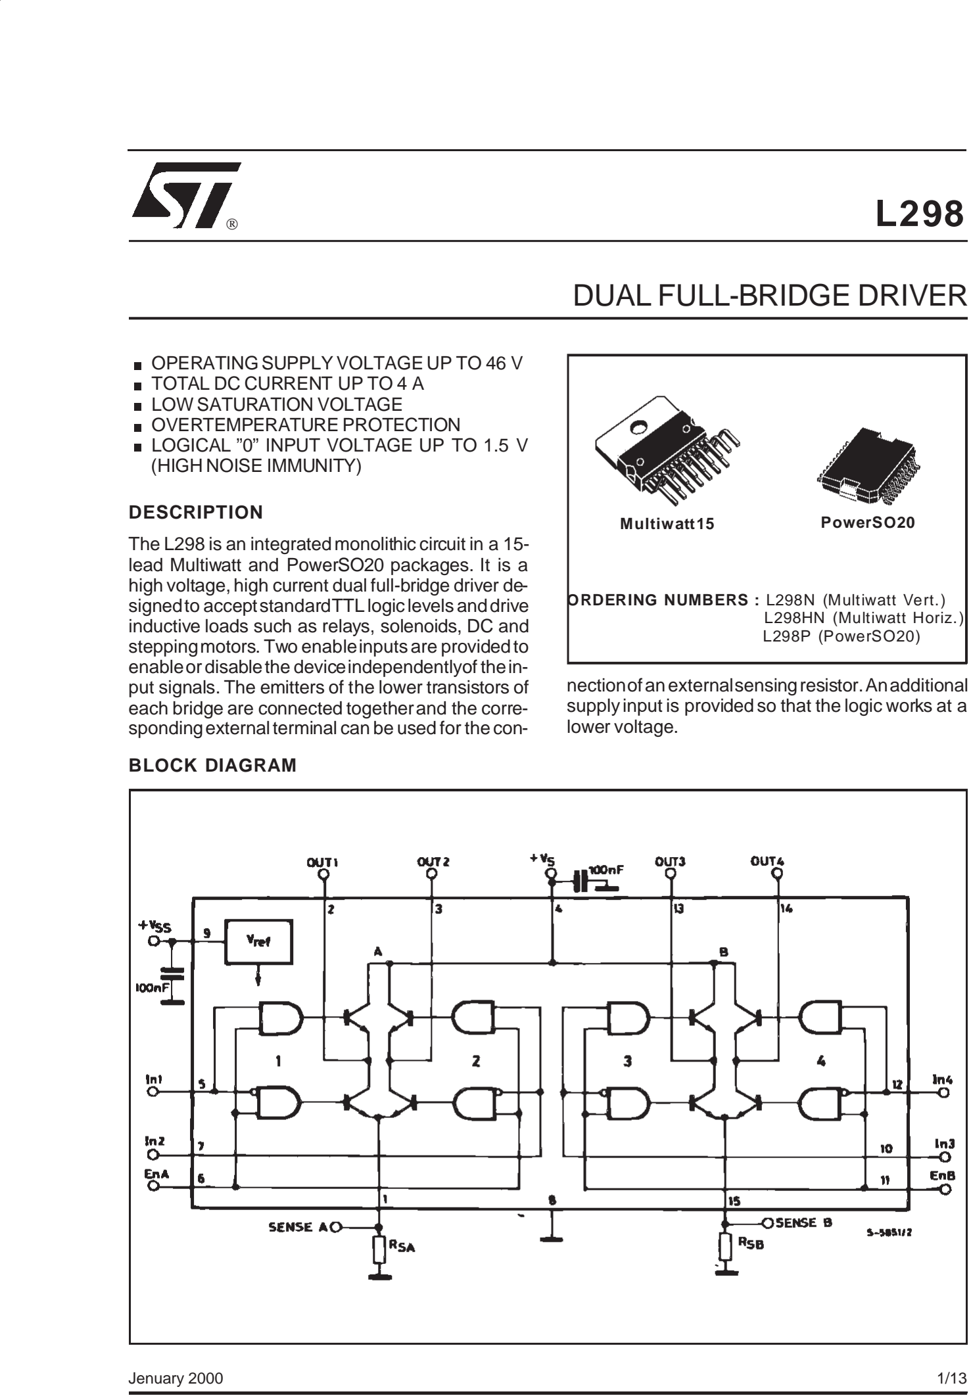
[picture p12: page 30]

Jenuary 2000

Multiwatt15

ORDERING NUMBERS : L298N (Multiwatt Vert.) L298HN (Multiwatt Horiz.)
L298P (PowerSO20)

## BLOCK DIAGRAM

## . OPERATING SUPPLY VOLTAGE UP TO 46 V . TOTAL DC CURRENT UP TO 4 A . LOW SATURATION VOLTAGE . OVERTEMPERATURE PROTECTION . LOGICAL ”0” INPUT VOLTAGE UP TO 1.5 V

## (HIGH NOISE IMMUNITY)

DESCRIPTION The L298 is an integrated monolithic circuit in a 15-lead Multiwatt and PowerSO20 packages. It is a high voltage, high current dual full-bridge driver de-signedto acceptstandardTTL logic levels anddrive inductive loads such as relays, solenoids, DC and steppingmotors. Two enableinputs are providedto enableor disablethe deviceindependentlyof thein-put signals. The emitters of the lower transistors of each bridge are connected togetherand the corre-spondingexternalterminal can be used for the con-

## nectionofanexternalsensingresistor.Anadditional supplyinput is provided so that the logic works at a

lower voltage.

PowerSO20

1/13

## ABSOLUTE MAXIMUM RATINGS

L298

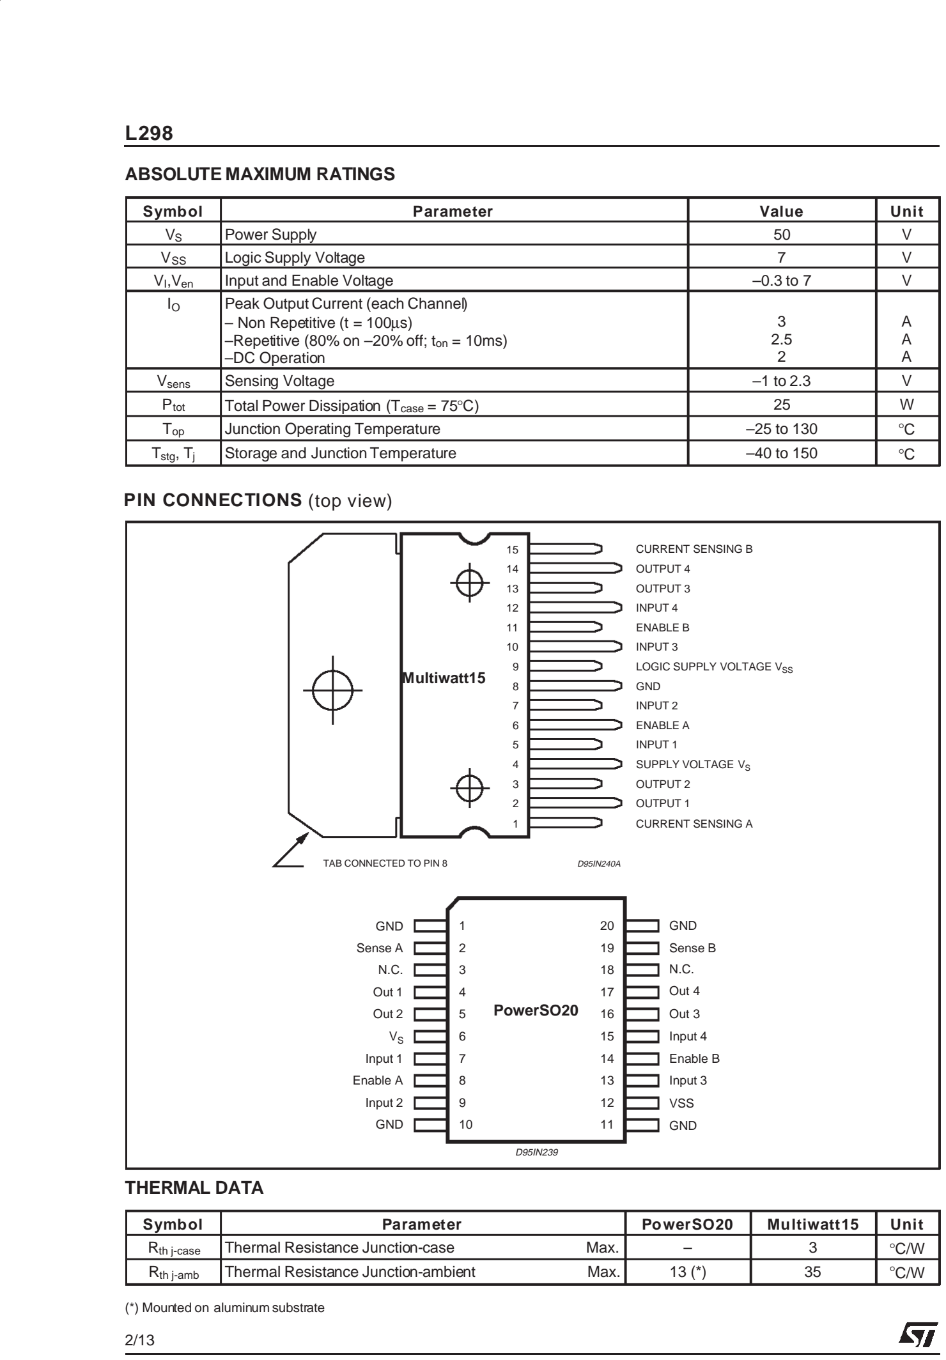
[picture p13: page 31]

## PIN CONNECTIONS (top view)

GND

Input 2 | VSS

N.C.
Out 1

VS

Out 2

Input 1
Enable A

Sense A

GND | 10
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
11 | GND

D95IN239

| Input 3

Enable B

Out 3
Input 4

Out 4

N.C.

Sense B

GND

Symbol | Parameter | Value | Unit
VS | Power Supply | 50 | V
VSS | Logic Supply Voltage | 7 | V
VI,Ven | Input and Enable Voltage | –0.3 to 7 | V
IO | Peak Output Current (each Channel) – Non Repetitive (t = 100µs) –Repetitive (80% on –20% off; ton = 10ms) –DC Operation | 3
| | 2.5
| | 2 | A A A
Vsens | Sensing Voltage | –1 to 2.3 | V
Ptot | Total Power Dissipation (Tcase = 75°C) | 25 | W
Top | Junction Operating Temperature | –25 to 130 | °C
Tstg,Tj | Storage and Junction Temperature | –40 to 150 | °C

## THERMAL DATA

Symbol | Parameter | | PowerSO20 | Multiwatt15 | Unit
Rth j-case | Thermal Resistance Junction-case | Max. | – | 3 | °C/W
Rth j-amb | Thermal Resistance Junction-ambient | Max. | 13 (*) | 35 | °C/W

(*) Mounted on aluminum substrate

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
ENABLE B
INPUT 3
LOGIC SUPPLY VOLTAGE VSS
GND
INPUT 2
ENABLE A
INPUT 1
SUPPLY VOLTAGE VS
OUTPUT 2
OUTPUT 1
CURRENT SENSING A

TAB CONNECTED TO PIN 8

13

14

15

12

CURRENT SENSING B
OUTPUT 4
OUTPUT 3
INPUT 4

D95IN240A

Multiwatt15

PowerSO20

2/13

## PIN FUNCTIONS (refer to the block diagram)

MW.15 | PowerSO | Name | Function
1;15 | 2;19 | Sense A; Sense B | Between this pin and ground is connected the sense resistor to
control the current of the load.
2;3 | 4;5 | Out 1; Out 2 | Outputs of the Bridge A; the current that flows through the load
connected between these two pins is monitored at pin 1.
4 | 6 | VS | Supply Voltage for the Power Output Stages.
A non-inductive 100nF capacitor must be connected between this pin and ground.
5;7 | 7;9 | Input 1; Input 2 | TTL Compatible Inputs of the Bridge A.
6;11 | 8;14 | Enable A; Enable B TTL Compatible Enable Input: the L state disables the bridge A
(enable A) and/or the bridge B (enable B).
8 | 1,10,11,20 | GND | Ground.
9 | 12 | VSS | Supply Voltage for the Logic Blocks. A100nF capacitor must be
connected between this pin and ground.
10; 12 | 13;15 | Input 3; Input 4 | TTL Compatible Inputs of the Bridge B.
13; 14 | 16;17 | Out 3; Out 4 | Outputs of the Bridge B. The current that flows through the load
connected between these two pins is monitored at pin 15.
– | 3;18 | N.C. | Not Connected

## ELECTRICAL CHARACTERISTICS (VS = 42V; VSS = 5V, Tj = 25°C; unless otherwise specified)

Symbol | Parameter | Test Conditions | Min. | Typ. | Max. | Unit
VS | Supply Voltage (pin 4) | Operative Condition | VIH +2.5 | | 46 | V
VSS | Logic Supply Voltage (pin 9) | | 4.5 | 5 | 7 | V
IS | Quiescent Supply Current (pin 4) | Ven = H; IL =0 | Vi =L
| | Vi =H | | 13
| | | | 50 | 22
| | | | | 70 | mA mA
Ven =L | Vi = X | 4 | mA
ISS | Quiescent Current from VSS (pin 9) Ven = H; IL =0 | Vi =L
| | Vi =H | | 24
| | | | 7 | 36
| | | | | 12 | mA mA
Ven =L | Vi = X | 6 | mA
ViL | Input Low Voltage (pins 5, 7, 10, 12) | | –0.3 | | 1.5 | V
ViH | Input High Voltage (pins 5, 7, 10, 12) | | 2.3 | | VSS | V
IiL | Low Voltage Input Current (pins 5, 7, 10, 12)
Vi = L | –10 | µA
IiH | High Voltage Input Current (pins 5, 7, 10, 12) | Vi = H ≤ VSS –0.6V | | 30 | 100 | µA
Ven = L Enable Low Voltage (pins 6, 11) | –0.3 | 1.5 | V
Ven = H Enable High Voltage (pins 6, 11) | 2.3 | VSS | V
Ien = L Low Voltage Enable Current
(pins 6, 11)
Ven = L | –10 | µA

Ien = H High Voltage Enable Current
(pins 6, 11)
| | Ven =H ≤ VSS –0.6V | | 30 | 100 | µA
VCEsat(H) Source Saturation Voltage | IL = 1A
IL = 2A
| | | 0.95 | 1.35
| | | | 2 | 1.7
| | | | | 2.7 | V V
VCEsat(L) Sink Saturation Voltage | IL = 1A (5)
| | IL = 2A (5) | 0.85 | 1.2
| | | | 1.7 | 1.6
| | | | | 2.3 | V V
VCEsat | Total Drop | IL = 1A (5)
| | IL = 2A (5) | 1.80 | | 3.2
| | | | | 4.9 | V V
Vsens | Sensing Voltage (pins 1, 15) | | –1 (1) | | 2 | V

L298

3/13

## ELECTRICAL CHARACTERISTICS (continued)

L298

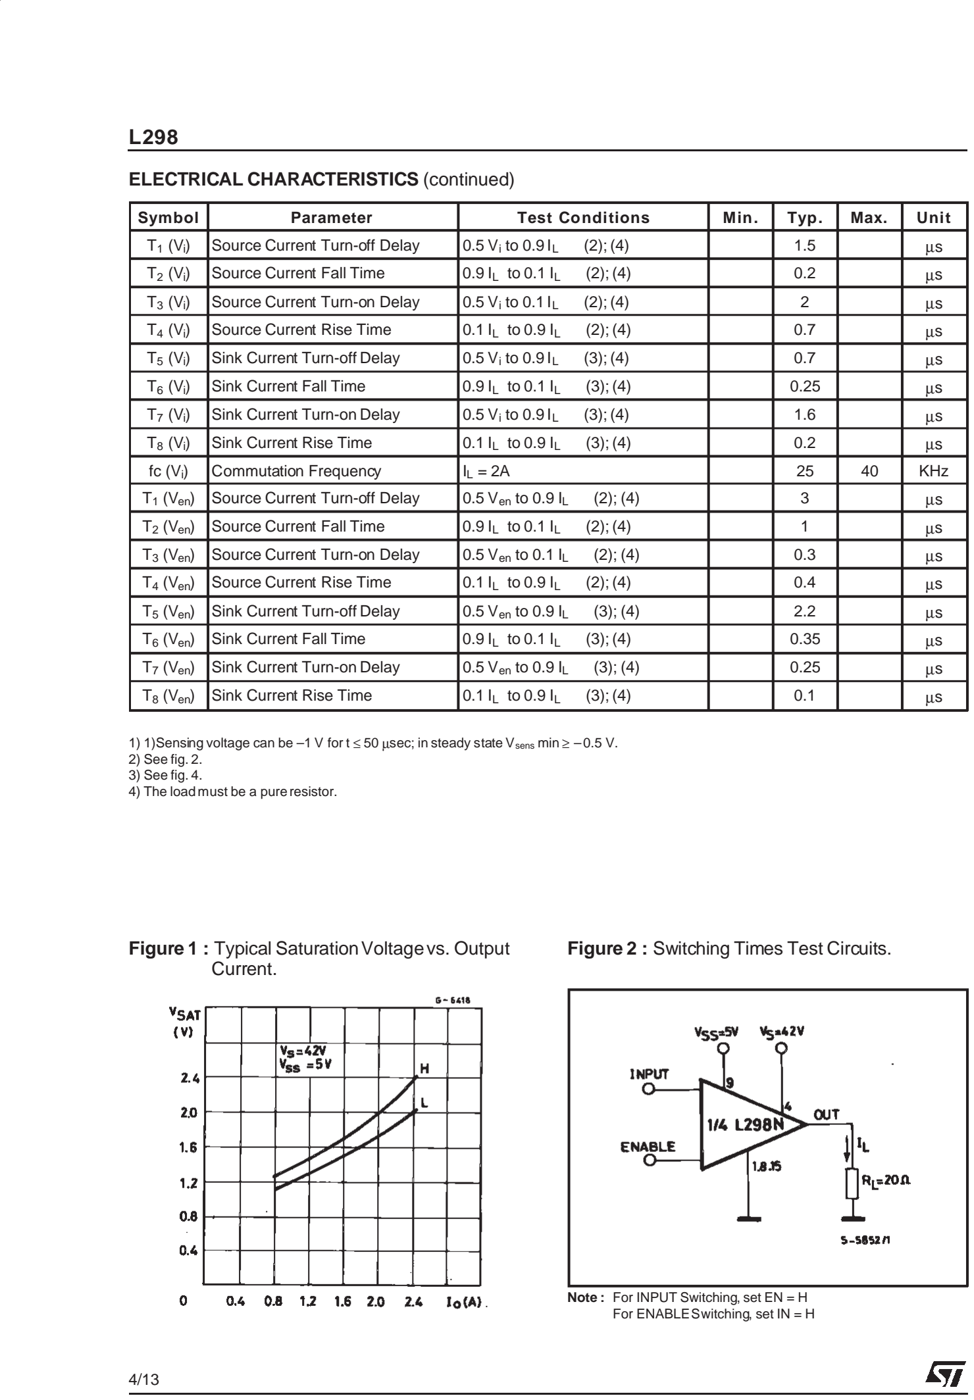
[picture p14: page 33]

## Figure 1 : Typical SaturationVoltagevs. Output

Current.

Figure 2 : Switching Times Test Circuits.

Note : For INPUT Switching, set EN = H For ENABLESwitching, set IN = H

1) 1)Sensing voltage can be –1 V for t ≤ 50 µsec; in steady state Vsens min ≥ –0.5 V.
2) See fig. 2.
3) See fig. 4.
4) The load must be a pure resistor.
Symbol | Parameter | Test Conditions | Min. | Typ. | Max. | Unit
T1 (Vi
) Source Current Turn-off Delay | 0.5 Vi to 0.9 IL | (2); (4) | 1.5 | µs
T2 (Vi
) Source Current Fall Time | 0.9 IL to 0.1 IL | (2); (4) | 0.2 | µs
T3 (Vi) Source Current Turn-on Delay | 0.5 Vi to 0.1 IL | (2); (4) | 2 | µs
T4 (Vi
) Source Current Rise Time | 0.1 IL to 0.9 IL | (2); (4) | 0.7 | µs
T5 (Vi) Sink Current Turn-off Delay | 0.5 Vi to 0.9 IL | (3); (4) | 0.7 | µs
T6 (Vi
) Sink Current Fall Time | 0.9 IL to 0.1 IL | (3); (4) | 0.25 | µs
T7 (Vi) Sink Current Turn-on Delay | 0.5 Vi to 0.9 IL | (3); (4) | 1.6 | µs
T8 (Vi) Sink Current Rise Time | 0.1 IL to 0.9 IL | (3); (4) | 0.2 | µs
fc (Vi) | Commutation Frequency | IL = 2A | 25 | 40 | KHz
T1 (Ven) Source Current Turn-off Delay | 0.5 Ven to 0.9 IL | (2); (4) | 3 | µs
T2 (Ven) Source Current Fall Time | 0.9 IL to 0.1 IL | (2); (4) | 1 | µs
T3 (Ven) Source Current Turn-on Delay | 0.5 Ven to 0.1 IL | (2); (4) | 0.3 | µs
T4 (Ven) Source Current Rise Time | 0.1 IL to 0.9 IL | (2); (4) | 0.4 | µs
T5 (Ven) Sink Current Turn-off Delay | 0.5 Ven to 0.9 IL | (3); (4) | 2.2 | µs
T6 (Ven) Sink Current Fall Time | 0.9 IL to 0.1 IL | (3); (4) | 0.35 | µs
T7 (Ven) Sink Current Turn-on Delay | 0.5 Ven to 0.9 IL | (3); (4) | 0.25 | µs
T8 (Ven) Sink Current Rise Time | 0.1 IL to 0.9 IL | (3); (4) | 0.1 | µs

4/13

Figure 3 : Source Current Delay Times vs. Input or Enable Switching.

L298

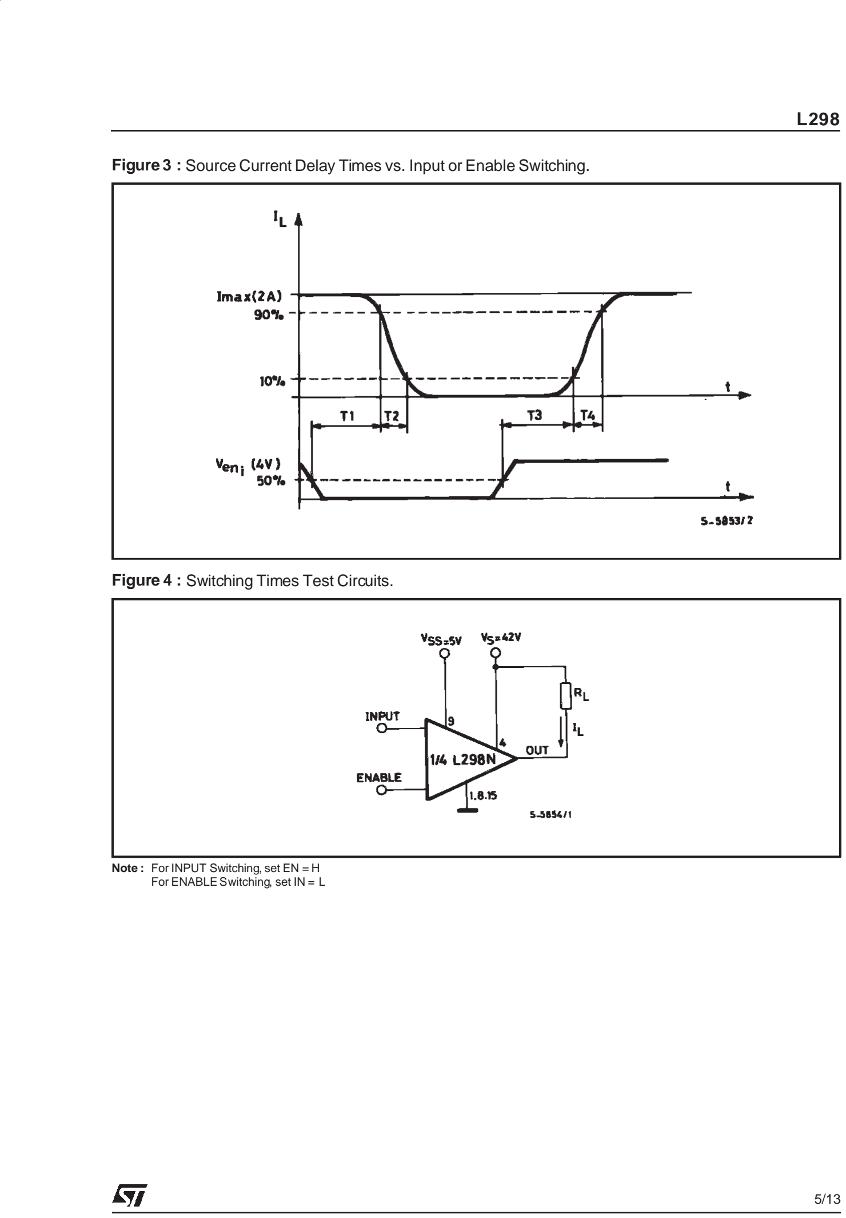
[picture p15: page 34]

Figure 4 : Switching Times Test Circuits.

Note : For INPUT Switching, set EN = H For ENABLE Switching, set IN = L

5/13

Figure 5 : Sink Current Delay Times vs. Input 0 V Enable Switching.

L298

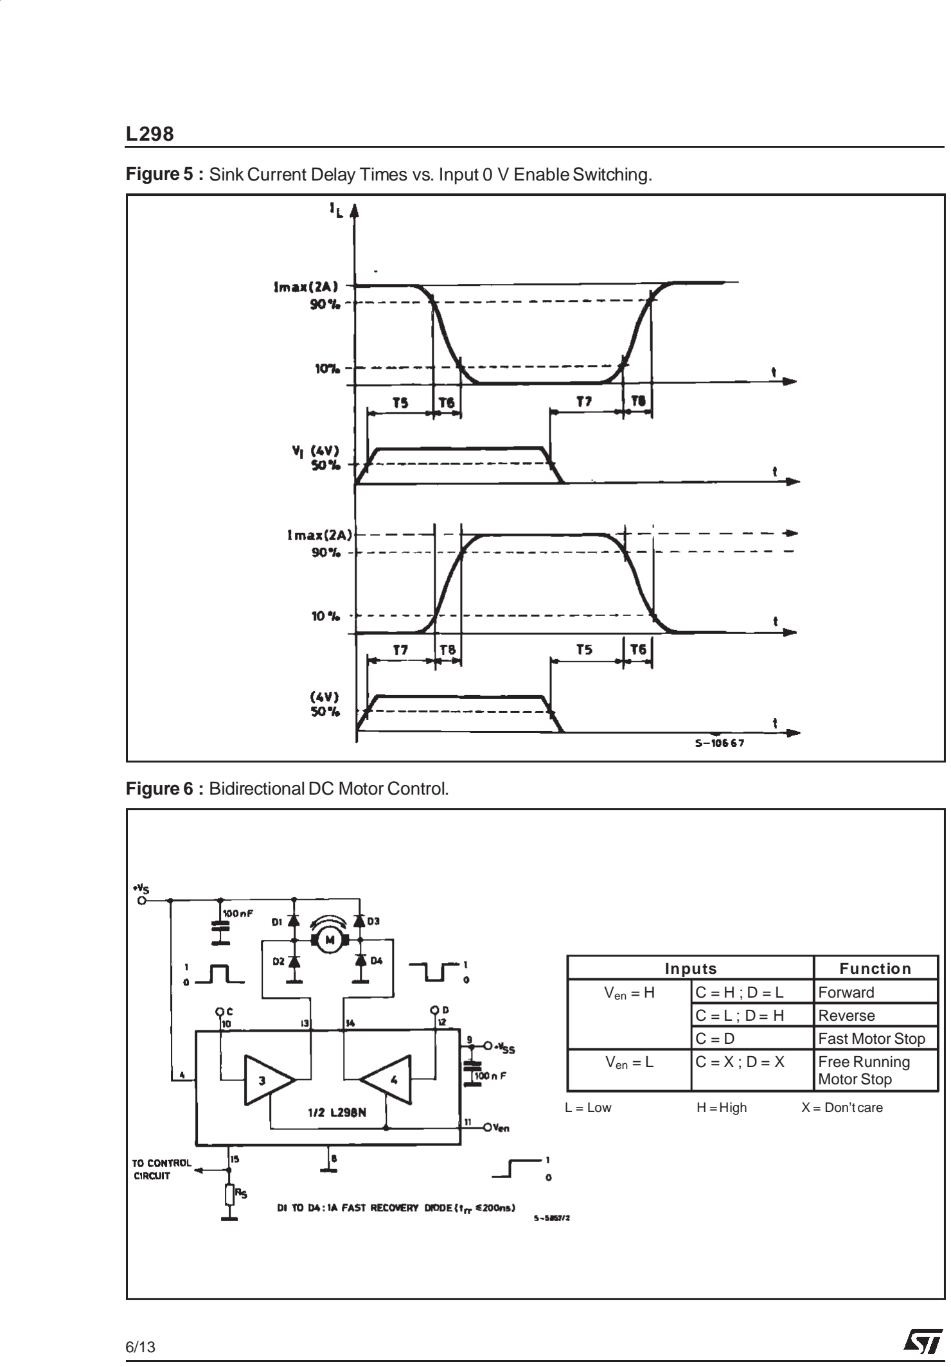
[picture p16: page 35]

Figure 6 : Bidirectional DC Motor Control.

L = Low | H = High | X = Don’t care
| Inputs | Function
Ven = H | C = H ; D = L | Forward
| C = L ; D = H | Reverse
| C = D | Fast Motor Stop
Ven = L | C = X ; D = X | Free Running Motor Stop

6/13

Figure 7 : For higher currents, outputs can be paralleled. Take care to parallel channel 1 with channel4 and channel2 with channel3.

## APPLICATION INFORMATION (Refer to the block diagram) 1.1. POWER OUTPUT STAGE

TheL298integratestwopoweroutputstages(A; B).

The power output stage is a bridge configuration and its outputs can drive an inductive load in com-monor differenzialmode, dependingon thestate of the inputs. The current that flows through the load comes out from the bridge at the sense output : an externalresistor (RSA ;RSB.) allows todetect the in-

tensity of this current.

## 1.2. INPUT STAGE Eachbridge is driven by meansof fourgatesthe in-

put of which are In1 ; In2 ; EnA and In3 ; In4 ; EnB.

## TheIninputsset thebridgestate whenThe En input

ishigh; a lowstateoftheEninputinhibitsthe bridge. All the inputs are TTL compatible.

## 2. SUGGESTIONS A non inductive capacitor, usually of 100 nF, must

be foreseen between both Vs and Vss, to ground,

## as near as possible to GND pin. Whenthe large capacitor of the power supply is too far from the IC, a second smaller one must be foreseen near the

L298.

## The sense resistor, not of a wire wound type, must be groundednear the negativepole of Vs that must

be nearthe GND pin of the I.C.

## Each input must be connected to the source of the

driving signals by means of a very short path.

## Turn-On and Turn-Off : Beforeto Turn-ONthe Sup-plyVoltageand beforeto Turnit OFF,the Enablein-

put must be driven to the Low state.

## 3. APPLICATIONS Fig 6 showsa bidirectional DC motor controlSche-

maticDiagram for which only one bridge is needed.

## The external bridge of diodes D1 to D4 is made by four fast recovery elements (trr ≤ 200 nsec) that must be chosen of a VF as low as possible at the

worst case of the load current.

## The senseoutputvoltagecanbeused to controlthe current amplitude by chopping the inputs,or to pro-vide overcurrent protectionby switching low theen-

able input.

## The brake function (Fast motor stop) requires that the Absolute Maximum Rating of 2 Amps must

never be overcome.

## When the repetitive peak current needed from the load is higher than 2 Amps, a paralleled configura-

tion can be chosen (See Fig.7).

## An external bridge of diodes are required when inductive loads are driven and when the inputsof the

ICare chopped; Shottkydiodeswouldbepreferred.

L298

7/13

© Semiconductor Components Industries, LLC, 2015
January, 2015 − Rev. 28

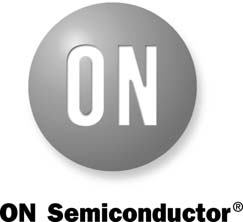
[picture p17: figure]

### 1 Publication Order Number:

LM358/D

LM258, LM358, LM358A,
LM2904, LM2904A,
LM2904V, NCV2904,

# NCV2904V

# Single Supply Dual

## Operational Amplifiers

Utilizing the circuit designs perfected for Quad Operational Amplifiers, these dual operational amplifiers feature low power drain, a common mode input voltage range extending to ground/VEE, and single supply or split supply operation. The LM358 series is equivalent to one−half of an LM324.
These amplifiers have several distinct advantages over standard operational amplifier types in single supply applications. They can operate at supply voltages as low as 3.0 V or as high as 32 V, with quiescent currents about one−fifth of those associated with the MC1741 (on a per amplifier basis). The common mode input range includes the negative supply, thereby eliminating the necessity for external biasing components in many applications. The output voltage range also includes the negative power supply voltage.

Features
- Short Circuit Protected Outputs
- True Differential Input Stage
- Single Supply Operation: 3.0 V to 32 V
- Low Input Bias Currents
- Internally Compensated
- Common Mode Range Extends to Negative Supply
- Single and Split Supply Operation
- ESD Clamps on the Inputs Increase Ruggedness of the Device

without Affecting Operation
- NCV Prefix for Automotive and Other Applications Requiring

Unique Site and Control Change Requirements; AEC−Q100 Qualified and PPAP Capable
- These Devices are Pb−Free, Halogen Free/BFR Free and are RoHS

Compliant

PDIP−8
N, AN, VN SUFFIX
CASE 626

1

8

SOIC−8
D, VD SUFFIX
CASE 751
1

8

PIN CONNECTIONS

VEE/Gnd

Inputs A
Inputs B

Output B

Output A | VCC

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
(Top View)

See general marking information in the device marking section on page 11 of this data sheet.

DEVICE MARKING INFORMATION

See detailed ordering and shipping information in the package dimensions section on page 10 of this data sheet.

ORDERING INFORMATION

Micro8-DMR2 SUFFIX
CASE 846A
1

8

www.onsemi.com

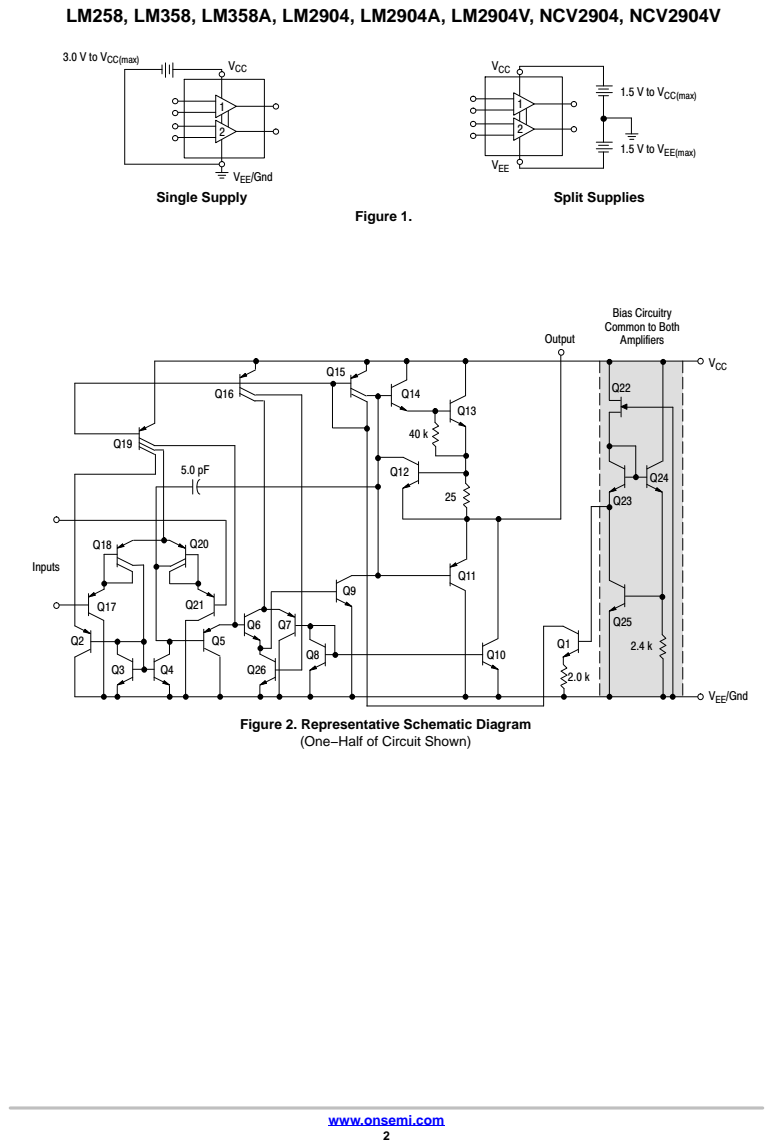
[picture p18: page 38]

Figure 2. Representative Schematic Diagram

(One−Half of Circuit Shown)

# TIP31C

## Power transistors

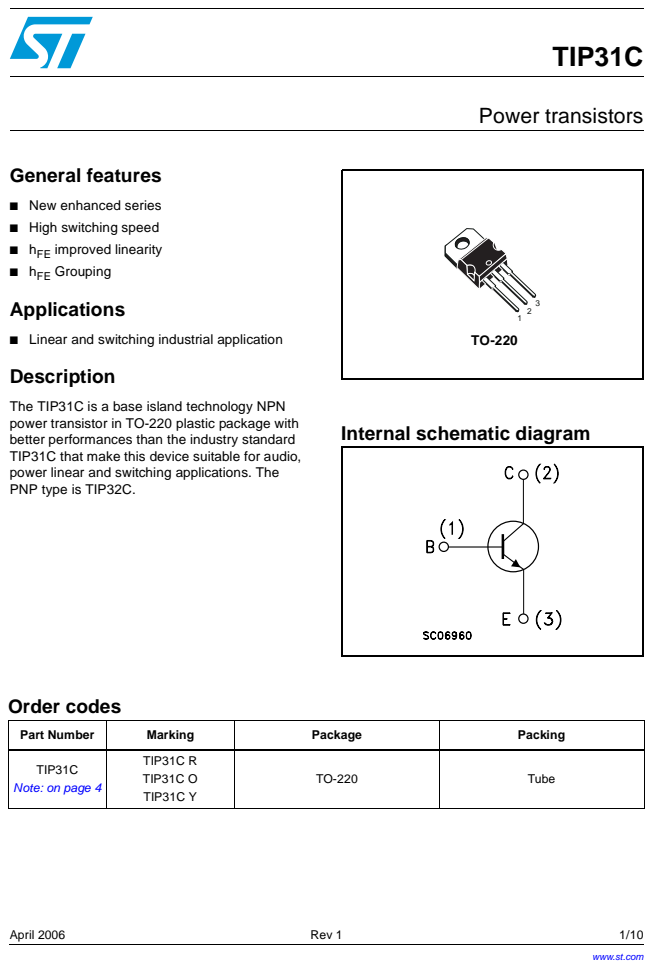
[picture p19: page 39]
April 2006; Rev 1; Order codes; General features; New enhanced series; High switching speed; hFE improved linearity; hFE Grouping; Applications; Linear and switching industrial application; Description

The TIP31C is a base island technology NPN
power transistor in TO-220 plastic package with
better performances than the industry standard
TIP31C that make this device suitable for audio,
power linear and switching applications. The
PNP type is TIP32C.

Internal schematic diagram

Part Number | Marking | Package | Packing

TIP31C Note: on page 4 | TIP31C R TIP31C O TIP31C Y | TO-220 | Tube

www.st.com

TIP31C | Absolute maximim ratings

3/10

# 1 Absolute maximim ratings

Table 1. | Absolute maximim ratings
Symbol | Parameter | Value | Unit
VCBO | Collector-base voltage (IE = 0) | 100 | V
VCEO | Collector-emitter voltage (IB = 0) | 100 | V
VEBO | Emitter-base voltage (IC = 0) | 5 | V
IC | Collector current | 3 | A
ICM | Collector peak current | 5 | A
IB | Base current | 1 | A
PTOT | Total dissipation at Tcase = 25°C Total dissipation at Tamb = 25°C | 40 2 | W W
Tstg | Storage temperature | -65 to 150 | °C
TJ | Max. operating junction temperature | 150 | °C

Electrical characteristics | TIP31C

4/10

## 2 Electrical characteristics

(Tcase = 25°C unless otherwise specified)

Note: | Product is pre-selected in DC current gain (Group R, Group O and Group Y). STMicroelectronics reserves the right to ship each groups according to production availability. Please contact your nearest STMicroelectronics sales office for delivery details.
Table 2. | Electrical characteristics
Symbol | Parameter | Test conditions | Min. | Typ. | Max. | Unit
ICEO | Collector cut-off current (IB = 0) | VCE = 60V | | | 0.3 | mA
IEBO | Emitter cut-off current (IC = 0) | VEB = 5V | | | 1 | mA
ICES | Collector cut-off current (VBE = 0) | VCE = 100V | | | 0.2 | mA
VCEO(sus)(1) | Collector-emitter sustaining voltage (IB = 0) | IC = 30mA | 100 | | | V
VCE(sat)(1) | Collector-emitter saturation voltage | I C = 3A_ I B = 375mA | | | 1.2 | V
VBE(on)(1) | Base-emitter voltage | IC = 3A_____ VCE = 4V | | | 1.8 | V
hFE(1) | DC current gain | I C = 1A_ ___ VCE = 4V IC = 3A _____ VCE = 4V Group R Group O Group Y | 25 10 20 40 | | 24 44 50
1. Pulsed duration = 300 ms, duty cycle ≥ 1.5%
