mfvazquez/PulseraTermicaAVR/Informe/imagenes/diagrama_de_bloques.png

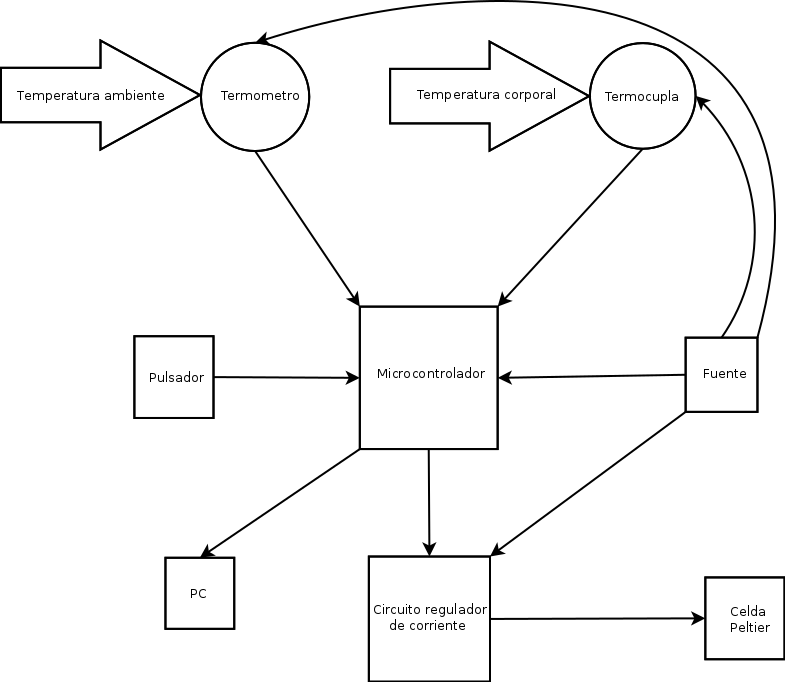
Informe/imagenes/diagrama_de_bloques.png
