mfvazquez/PulseraTermicaAVR/Informe/imagenes/IMG_20150624_204237861.jpg

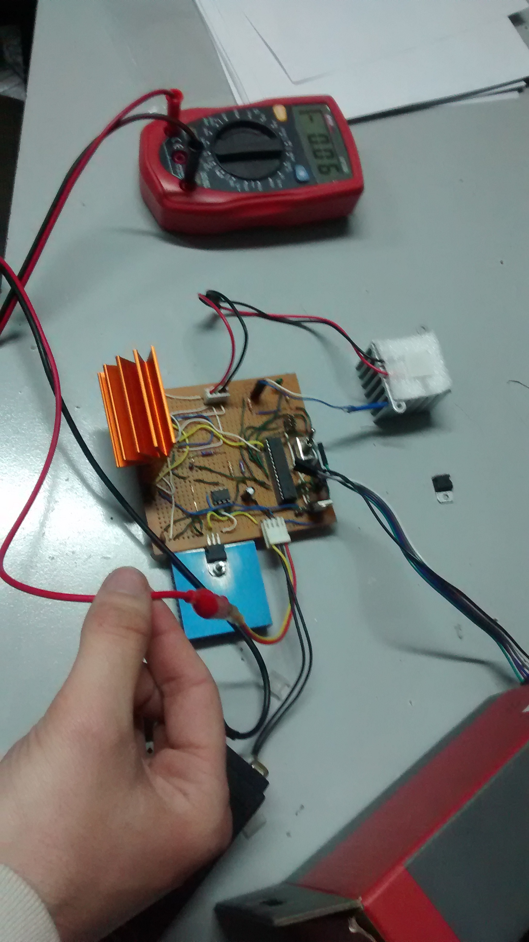
Informe/imagenes/IMG_20150624_204237861.jpg
