mfvazquez/PulseraTermicaAVR/Informe/imagenes/IMG_20150624_204240107.jpg

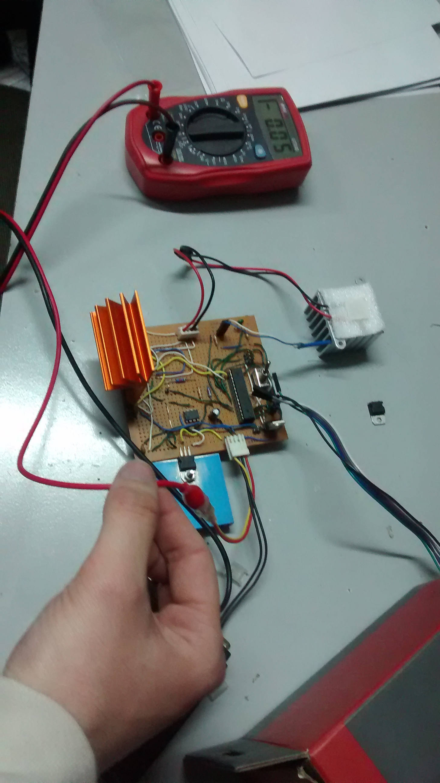
Informe/imagenes/IMG_20150624_204240107.jpg
