mfvazquez/PulseraTermicaAVR/Informe/imagenes/IMG_20150624_204254802_HDR.jpg

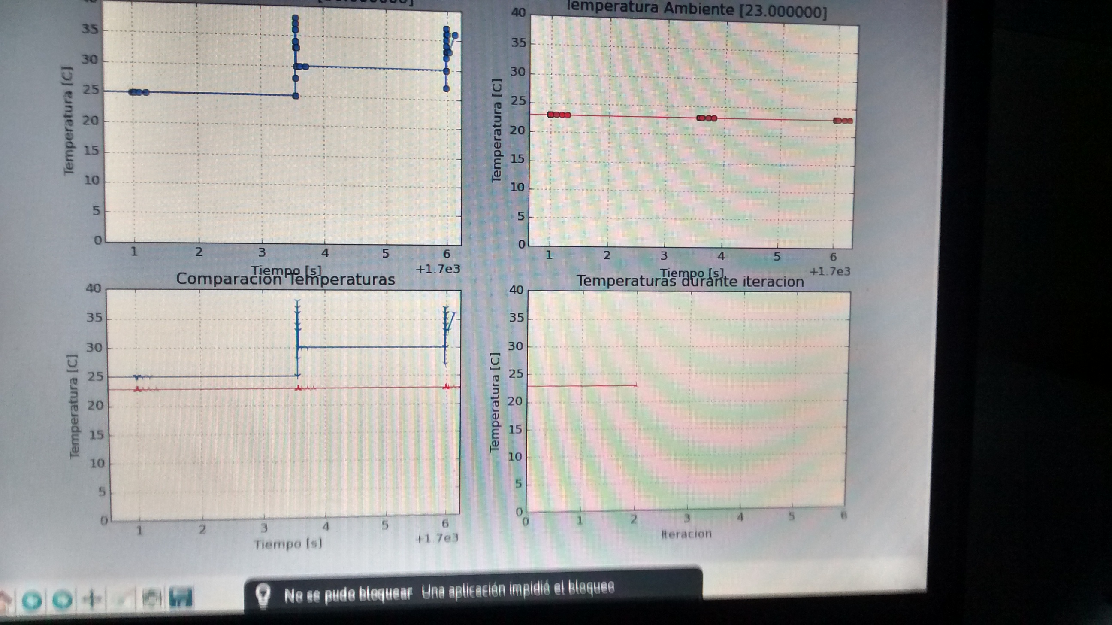
Informe/imagenes/IMG_20150624_204254802_HDR.jpg
