mfvazquez/PulseraTermicaAVR/Informe/imagenes/IMG_20150624_205027621.jpg

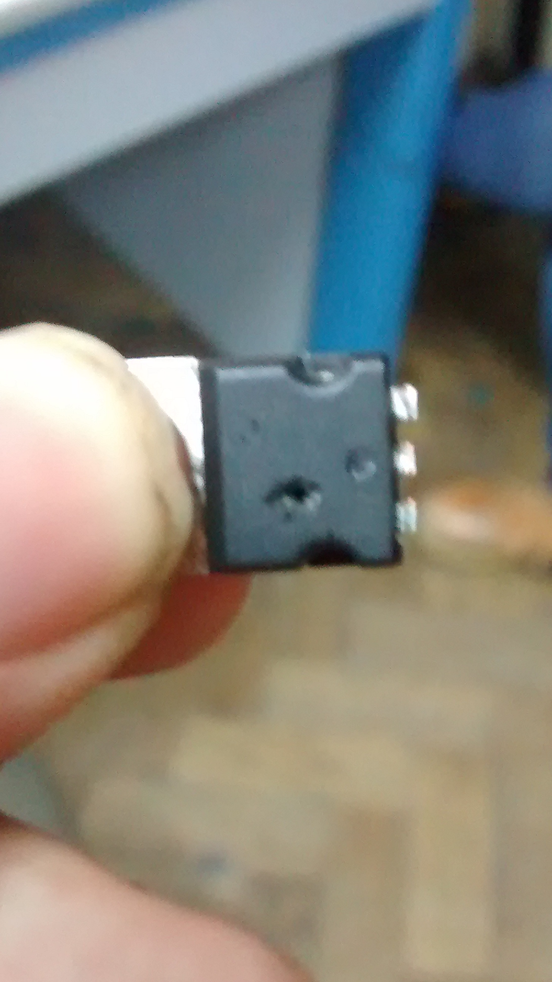
Informe/imagenes/IMG_20150624_205027621.jpg
