mfvazquez/PulseraTermicaAVR/circuitos/circuito_profesor.pdf

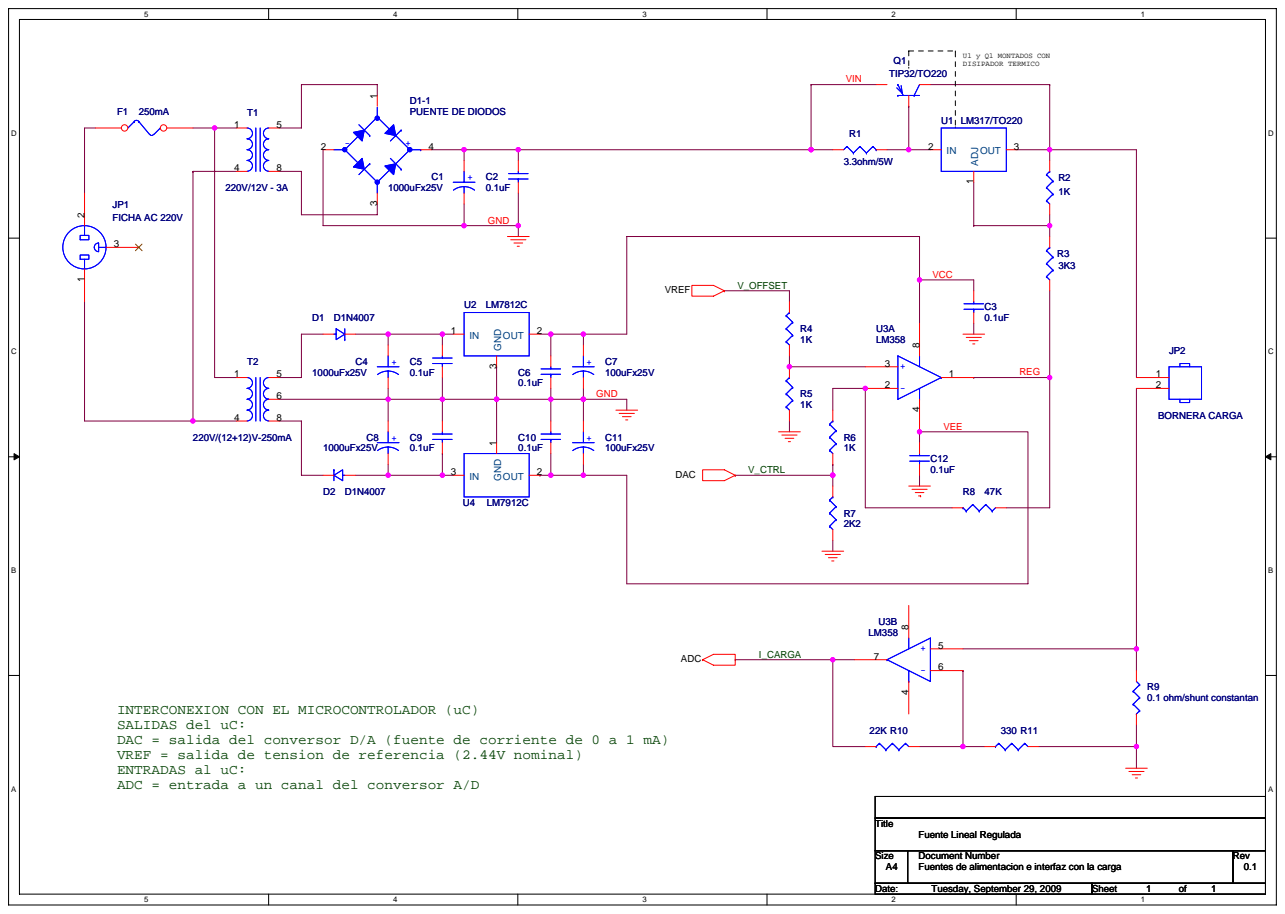
[picture p25: page 1]

C | | U2 LM7812C | VCC | REG | JP2 | C

SALIDAS del uC:
DAC = salida del conversor D/A (fuente de corriente de 0 a 1 mA)
VREF = salida de tension de referencia (2.44V nominal)
ENTRADAS al uC:
ADC = entrada a un canal del conversor A/D

Title Title Title Fuente Lineal Regulada Fuente Lineal Regulada Fuente Lineal Regulada

Size Size Size A4 A4 A4 | Document Number Document Number Document Number Fuentes de alimentacion e interfaz con la carga Fuentes de alimentacion e interfaz con la carga Fuentes de alimentacion e interfaz con la carga | | Rev Rev Rev 0.1 0.1 0.1

Date: Date: Date: Tuesday, September 29, 2009 Tuesday, September 29, 2009 Tuesday, September 29, 2009 | | Sheet Sheet Sheet 1 1 1 of of of 1 1 1
