mfvazquez/PulseraTermicaAVR/Informe/imagenes/diagrama_de_bloques.pdf

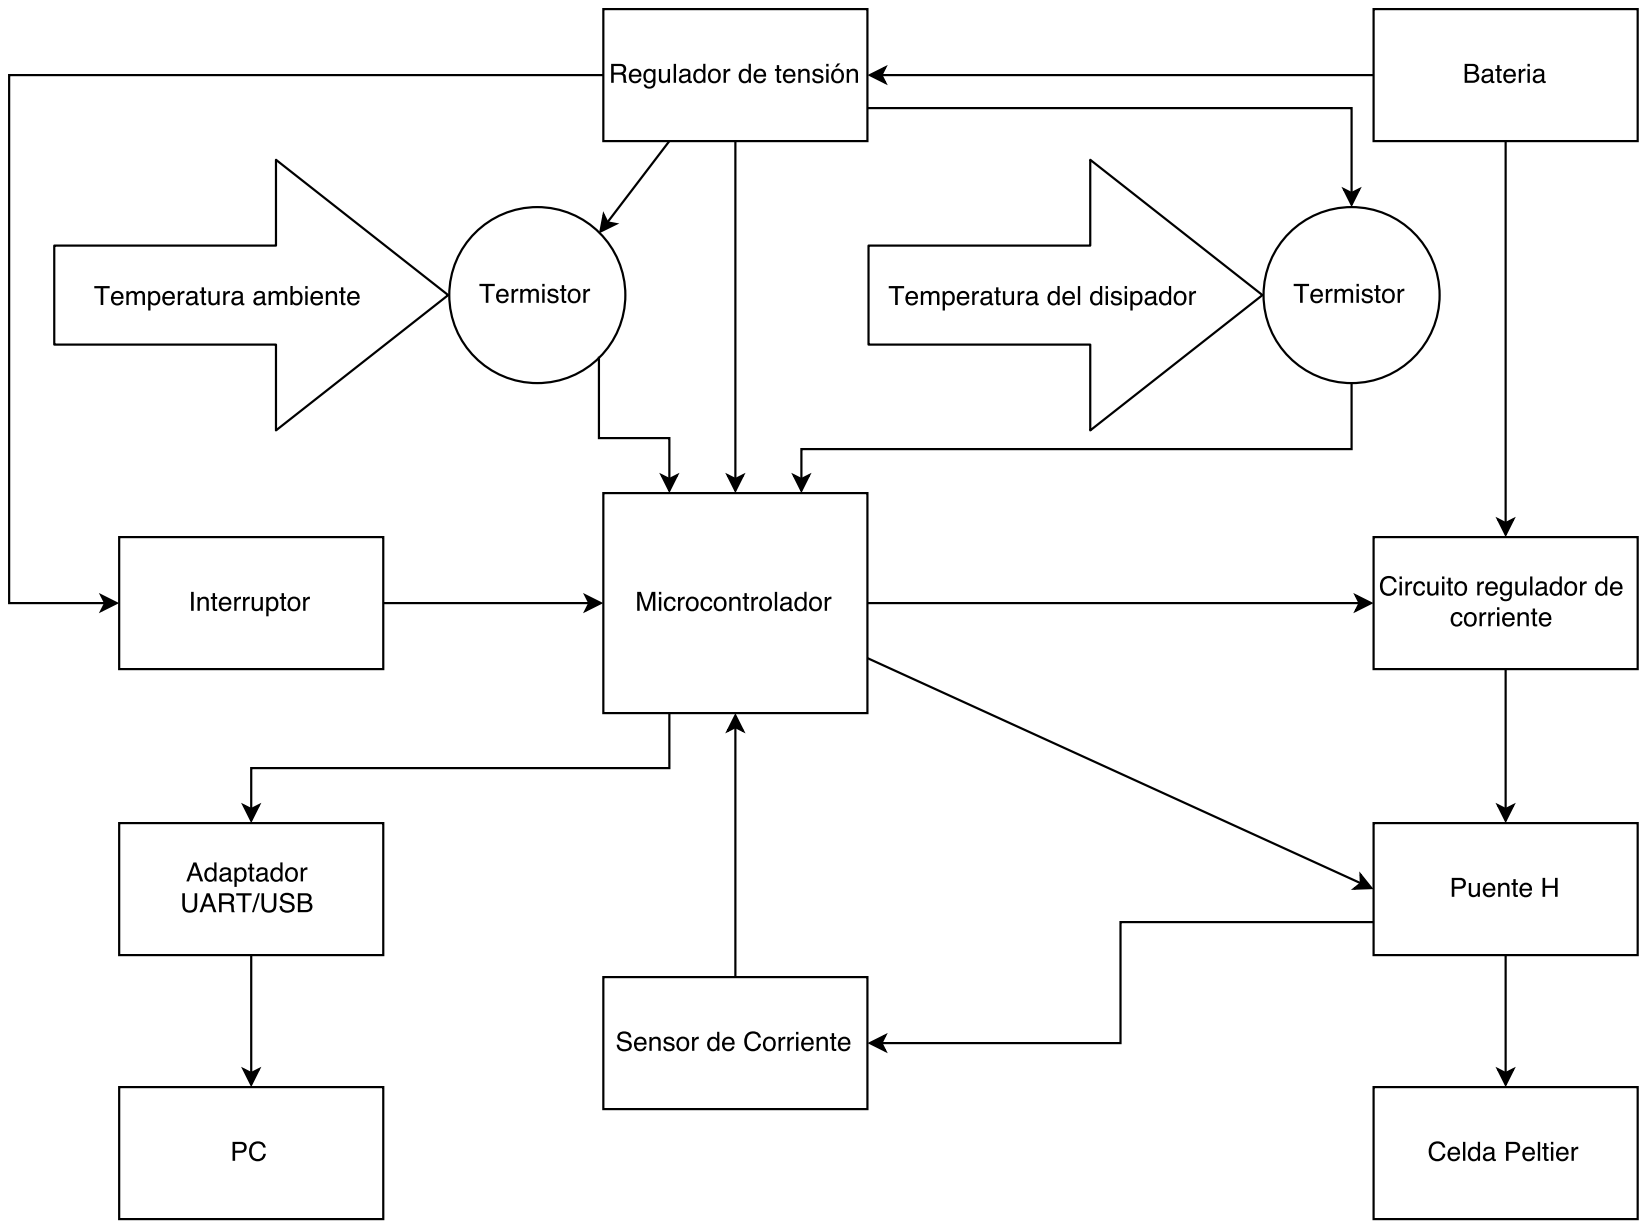
[picture p26: page 1]
