mfvazquez/PulseraTermicaAVR/Informe/imagenes/diagrama_de_flujo.pdf

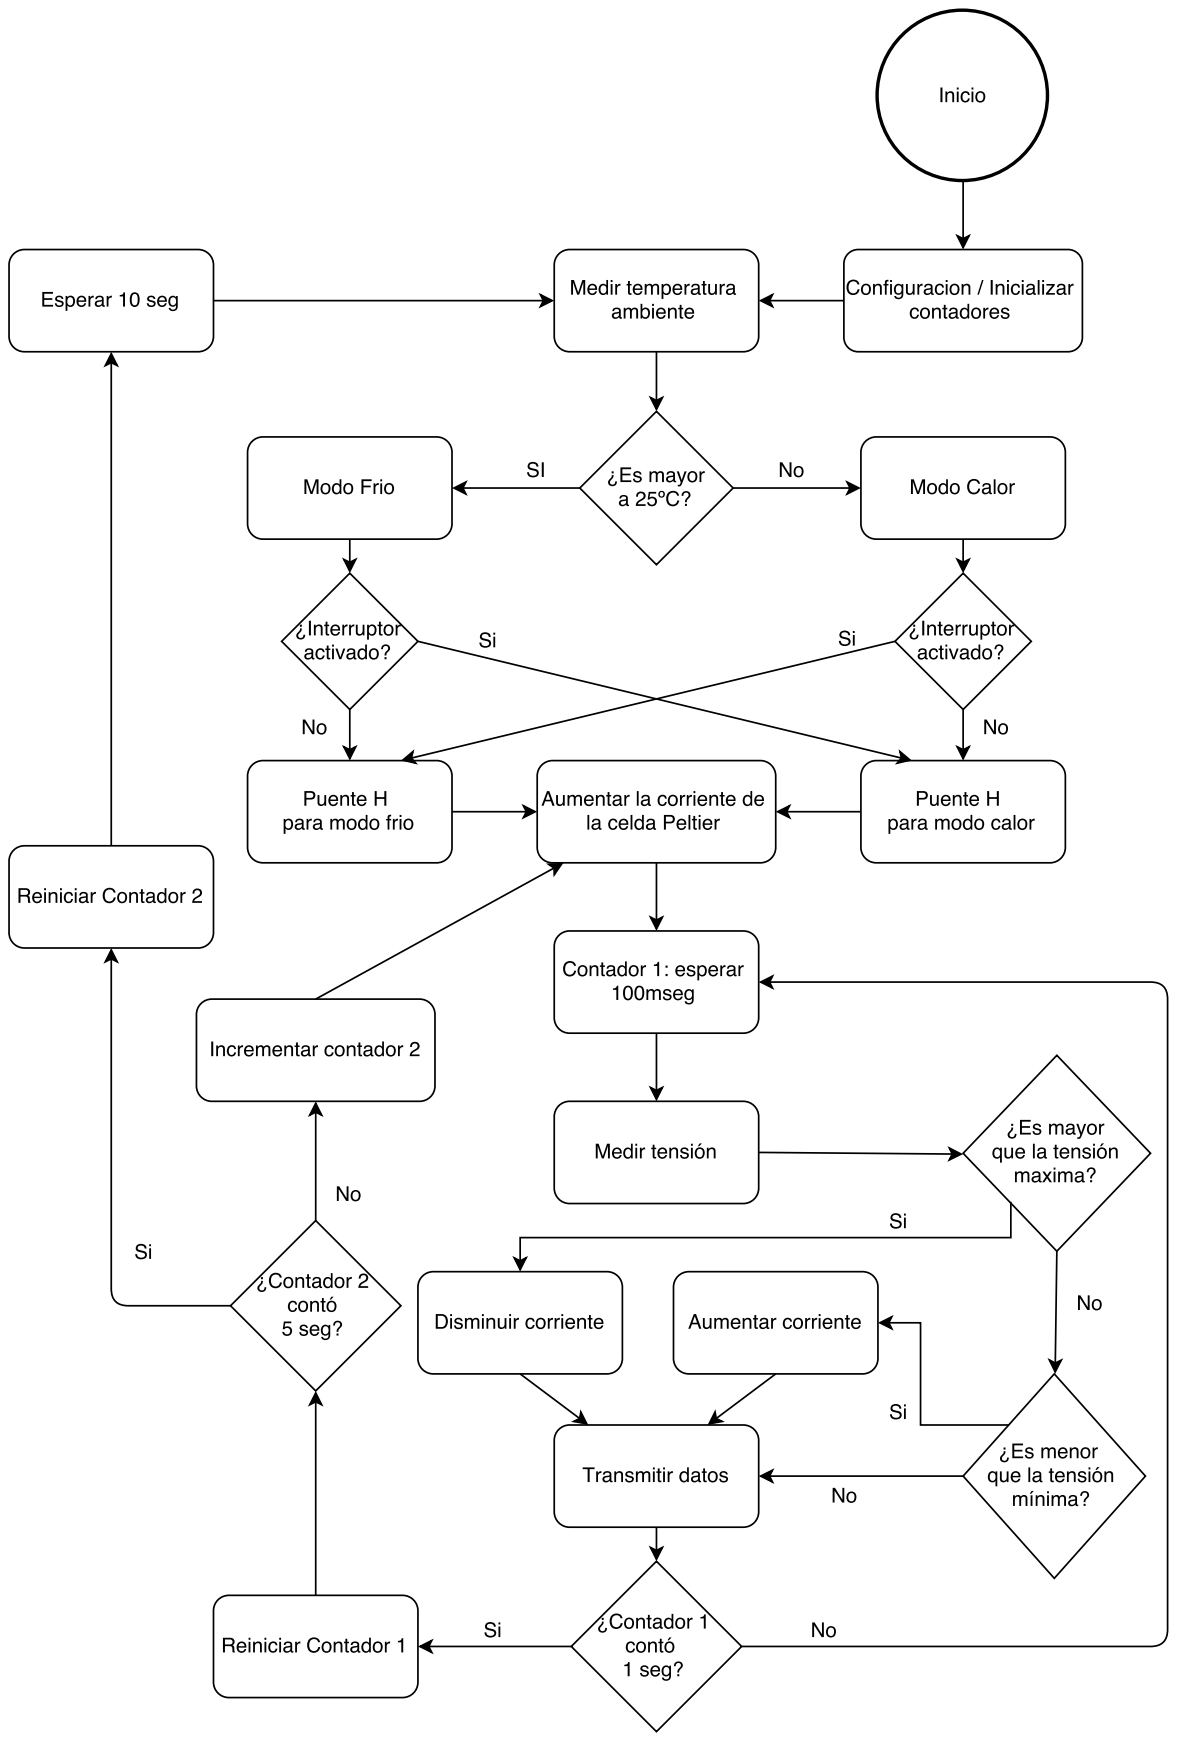
[picture p27: page 1]
