mfvazquez/PulseraTermicaAVR/circuitos/esquematico.pdf

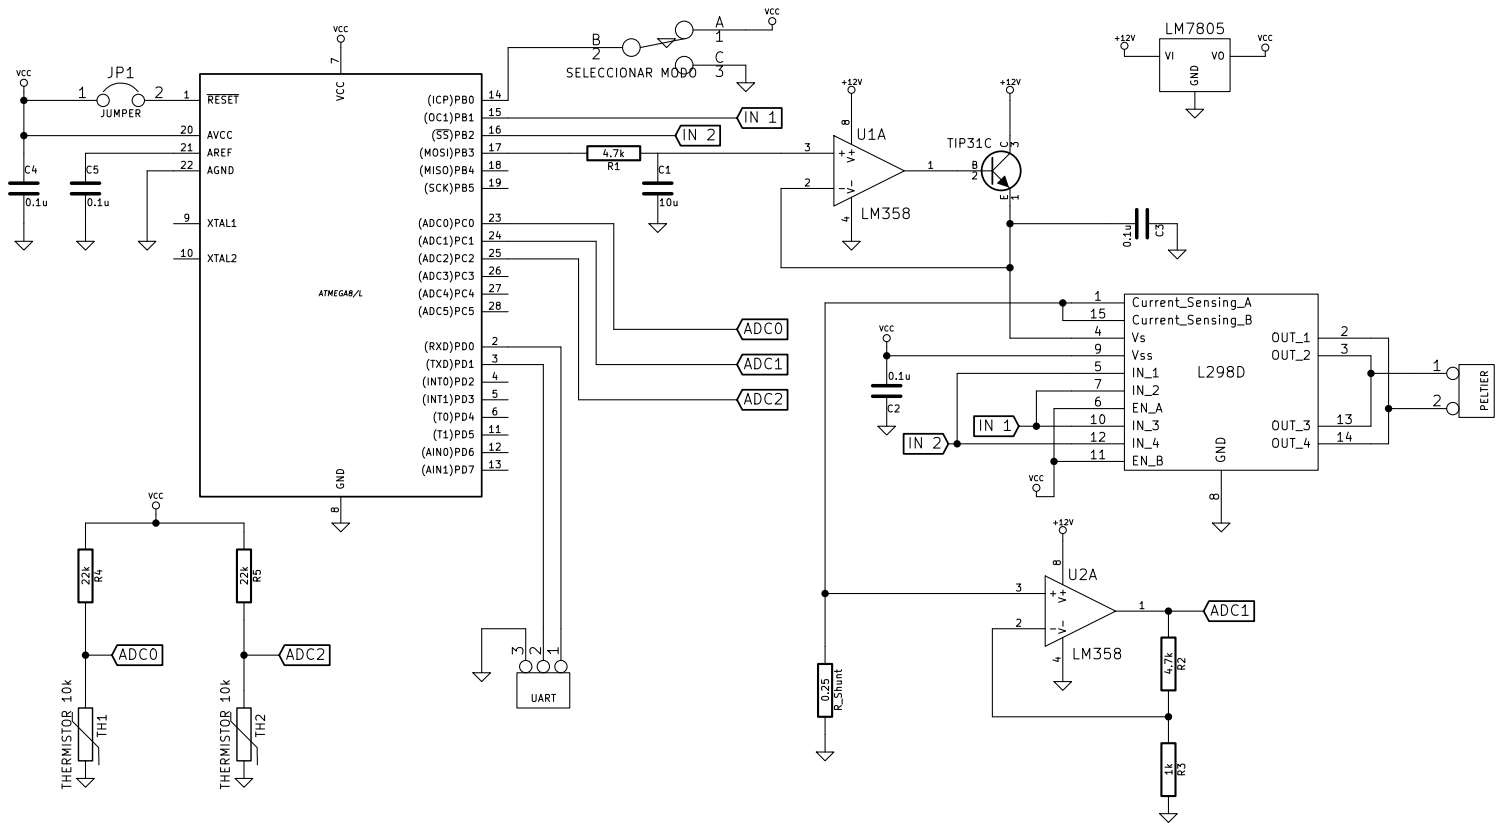
[picture p28: page 1]
