mfvazquez/PulseraTermicaAVR/circuitos/regulador_corriente.pdf

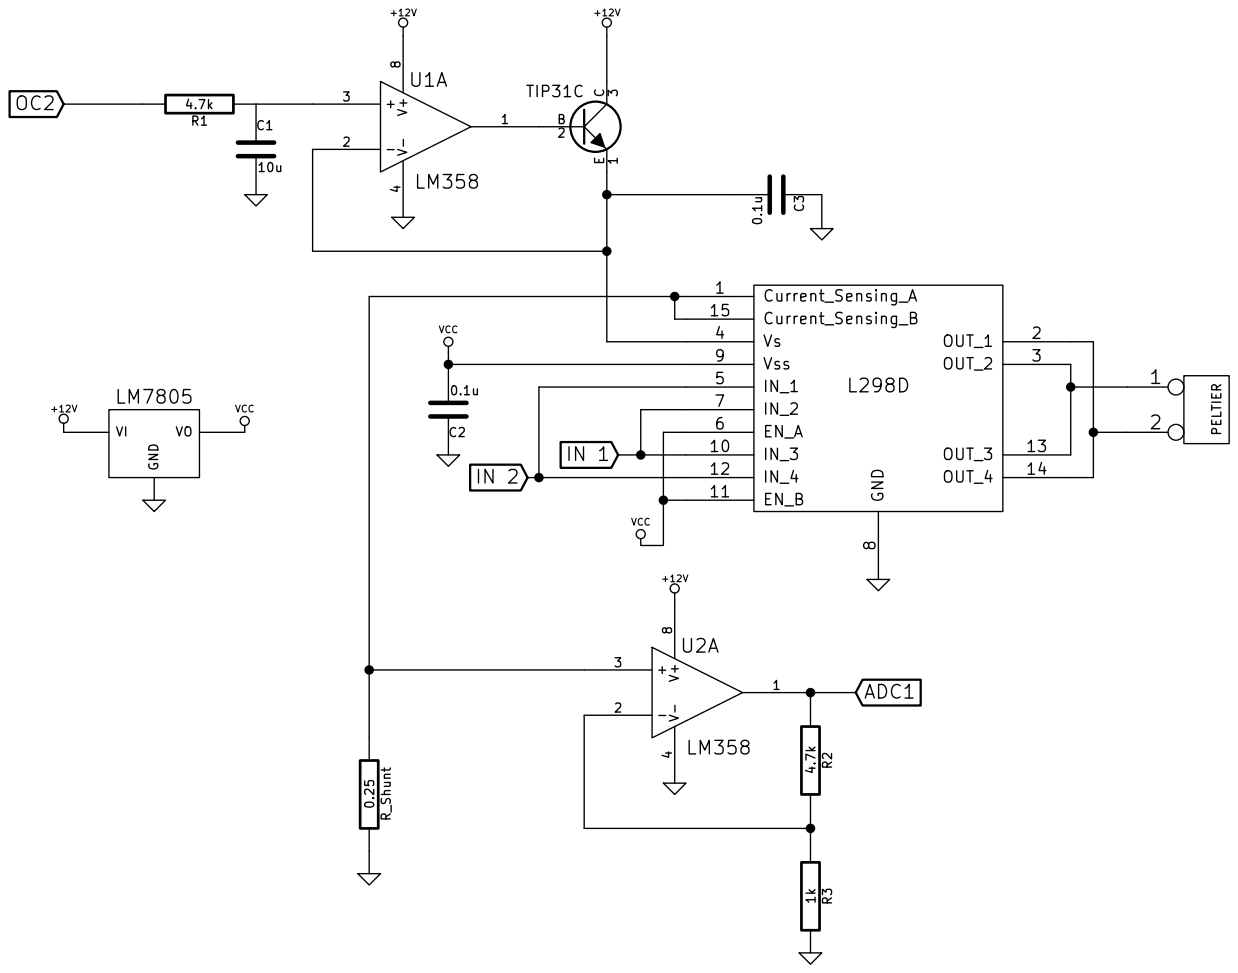
[picture p29: page 1]
