mfvazquez/PulseraTermicaAVR/circuitos/temperatura.pdf

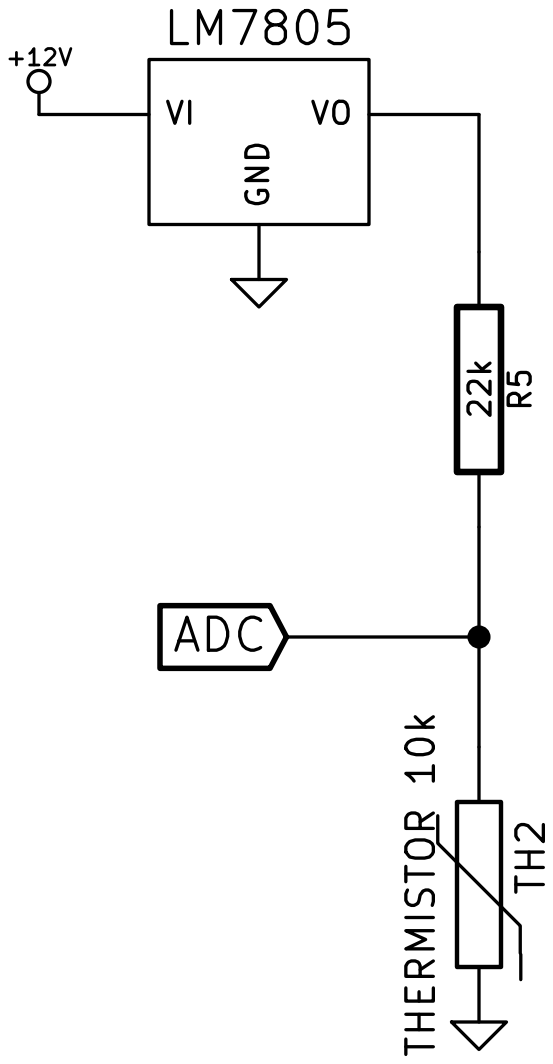
[picture p30: page 1]
