mfvazquez/PulseraTermicaAVR/circuitos/fuente_de_corriente.asc

C1: cap; 10µ
constantan: res; 0.5
peltier: res; 1
Q1: npn; ZTX1048A
R1: res; 4.7k
R2: res; 330
R3: res; 15k
U1: opamp2; LM358
U2: opamp2; LM358
V1: voltage; 12
V2: voltage; PULSE(0 5 0 0 0 0.05m 0.5m)
V3: voltage; 12
Named nets: 0
.tran 1
.INCLUDE LM358.lib
