mfvazquez/PulseraTermicaAVR/circuitos/esquematico.sch

## KiCad design circuitos/esquematico.sch (2015-06-30)

Schematic: esquematico.sch

Parts:
C1: 10u
C2, C3, C4, C5: 0.1u
JP1: JUMPER
R1, R2: 4.7k
R3: 1k
R4, R5: 22k
R_Shunt: 0.25
TH1, TH2: THERMISTOR 10k
U1, U2: LM358
