mfvazquez/PulseraTermicaAVR/circuitos/regulador_corriente.sch

## KiCad design circuitos/regulador_corriente.sch (2015-06-30)

Schematic: regulador_corriente.sch

Parts:
C1: 10u
C2, C3: 0.1u
R1, R2: 4.7k
R3: 1k
R_Shunt: 0.25
U1, U2: LM358
