mfvazquez/PulseraTermicaAVR/circuitos/temperatura.sch

## KiCad design circuitos/temperatura.sch (2015-06-29)

Schematic: temperatura.sch

Parts:
R5: 22k
TH2: THERMISTOR 10k
