mfvazquez/PulseraTermicaAVR/(commit log)

2015-03-31 Clase de prender led
2015-03-31 Cambie la licencia
2015-03-31 Creo carpeta con snipets de clases
2015-04-05 Inicie el informe
2015-04-05 Inicié el informe
2015-04-08 agregué un par de cosas mas a las especificaciones
2015-04-08 Makefile andando y el programa prende el led en el proto
2015-04-11 Saco las cosas de mas
2015-04-11 Agrego el codigo que intentamos hacer andar el otro dia
2015-04-11 Fixed los errores. En el emulador + gdb el programa anda correctamente
2015-04-12 arreglado led.S
2015-04-18 Agrego templates para los ej y parte del ej1
2015-04-18 Agrego una parte del ej1, el setup del stack
2015-04-19 Agrego el ejercicio 2
2015-04-21 hice el ej1.S
2015-04-21 termine el ej2
2015-04-22 termine de pasar el anteproyecto a latex
2015-04-22 agregue un diagrama de bloques a Informe.tex
2015-04-22 centre los textos del diagrama de bloques en Informe.tex
2015-05-13 agregué la parte del circuito regulador de corriente del informe
2015-05-13 agregue el diagrama de bloques a la carpeta imagenes
2015-05-13 arreglado el diagrama de flujo
2015-05-13 actualizado el informe
2015-05-13 agregue algo que me olvide en el informe
2015-05-13 subi el pdf compilado
2015-05-17 Agrego el makefile
2015-05-17 Agrego para que no la muertee el clean
2015-05-17 Agrego las cosas que sino rompen en Linux
2015-05-17 inicializo los registros que se usan para inicializar el usart
2015-05-24 agregue el circuito generador de corriente en ltspice
2015-05-24 arregle el circuito de la fuente de corriente
2015-05-25 modificada la fuente de corriente
2015-05-26 Agrego para tener un codigo base de pwm
2015-05-27 actualice el circuito y agregue la libreria del LM358
2015-05-31 Agrego lo que hicimos el otro dia en clase
2015-05-31 Agrego un bauld rate que funcione com picocom
2015-05-31 Arreglo un poco como es en el libro
2015-06-02 agregue el datasheet correcto y agregue cosas al circuito
2015-06-02 Arreglo para mejorar la legibilidad del codigo
2015-06-03 arregle el valor de unas recistencias en el circuito fuente de corriente
2015-06-06 Cambio el nombre del archivo con cosas para testear
2015-06-06 Agrego para tener ahora si un archivo con el codigo final
2015-06-06 Agrego el loop principal del programa
2015-06-10 Agrego script para leer y algo al codigo para que mande
2015-06-10 Arreglo un problema ahi con la instruccion
2015-06-10 Por las dudas que este defasado
2015-06-11 Actualizo las cosas de la clase
2015-06-12 Agrego las mediciones de hoy
2015-06-14 agregue el timmer y algunas cosas mas
2015-06-15 Agrego el reader, ahora esta recontra mockeado
2015-06-15 Agrego un sleep para que no sea un bussy loop
2015-06-18 Saco las cosas que se agregaron ayer por comitear a los chapazos
2015-06-19 modifique el timer, ahora es de 16 bits y modifique standby en base al timer nuevo
2015-06-20 Cambio un par de cosas al codigo y mejoro los datos de compilacion
2015-06-20 Agrego una copia del pulsera para tener por las dudas
2015-06-20 Agrego el codigo de la tabla de conversion
2015-06-20 Arreglo los problemas con el init del stack
2015-06-20 agrege el interruptor
2015-06-21 agregue un ejemplo para leer y escribir de eeprom
2015-06-21 Agrego opciones al makefile para poder saber que es lo que esta pasando con los simbolos
2015-06-21 Agrego otro comando para monitorear el tamaño del codigo
2015-06-21 agregue la tabla del termistor
2015-06-21 Agrego un makefile que aparentemente hace lo que tiene que hacer
2015-06-21 Agrego un codigo eeprom de prueba
2015-06-21 agregue la generacion del .eep al makefile viejo, y renombre al nuevo por makefile_feo
2015-06-21 Agrego la tabla del termistor a la parte del eeprom
2015-06-21 Agrego algo de lo que cambie al informe (casi nulo)
2015-06-22 agregue las tablas actualizadas al pulsera.S y actualice el Makefile
2015-06-22 Cambio un poco de leer eeprom para poder usarlo
2015-06-22 Agrego las traducciones de lo leido
2015-06-22 Agrego las traducciones in line que faltaban
2015-06-22 agrege el regulador del pwm, no se porque imprime mal la temperatura del peltier y antes lo hacia bien
2015-06-23 semiterminado el tp(?)
2015-06-23 agregue el circuito para el informe
    [esquematico.sch]
2015-06-23 arregle las tablas de la temperatura del peltier
2015-06-24 Agrego las cosas de hoy
2015-06-24 Agrego lo que no podia agregar antes para que se incluya el codigo del tp
2015-06-24 Formateo un poco el codigo
2015-06-24 Cambio el valor de la cte
2015-06-24 Termino con el formateo
2015-06-24 saco una tilde que rompia
2015-06-24 Cambio donde busca el tex el codigo del proyecto
2015-06-24 Agrego un par de modificaciones al informe
2015-06-24 actualizado el codigo
2015-06-24 Saco el versionado del pdf que hace bulto al pedo
2015-06-24 agregue los datasheets que faltaban
2015-06-24 Agrego la tabla para poner los costos
2015-06-24 Agrego un par de los registros seteados
2015-06-24 Cambio una tabulacion para que quede bien despues todo legible
2015-06-24 continué con el informe y agregue unos circuitos
    [esquematico.sch, regulador_corriente.sch, temperatura.sch]
2015-06-24 me olvide de commitear algo
2015-06-24 segui con el informe
2015-06-29 borre la carpeta de octave
2015-06-29 Agrego lo que se cambio el otro dia
2015-06-29 arregle los circuitos del informe y la lista de precios
    [esquematico.sch, regulador_corriente.sch, temperatura.sch]
2015-06-29 agregue la caratula y borre lo que estaba de mas en las concluciones
2015-06-29 agregue el diagrama de flujo arreglado
2015-06-29 me olvide de addear el informe
2015-06-29 ya arregle todo lo que figura en mis hojas y lo que recuerdo del informe
2015-06-30 Cambio un par de boludeces del informe
2015-06-30 arregle lo que marcaron en el informe
    [esquematico.sch, regulador_corriente.sch]
2015-06-30 agregue una seccion de autrregulacion de la corriente en el informe
2015-06-30 Agrego las fotos de la presentacion
2015-07-01 termine de corregir el informe
2015-07-01 termine de corregir las concluciones
2015-10-02 agregue un codigo extra con mediciones que hice para probar el rendimiento del dispositivo
